DVA-4/RobotChant/THIRD_PARTY.md

# Third-party material

The firmware and tools are GPL-2.0 (see `LICENSE`). This file lists what came
from elsewhere and under what terms.

## `firmware/07j_pacing/standardDict.cpp`

The 1,427-word dictionary from Mike McCauley's
[SpeakJet library for Arduino](https://www.airspayce.com/mikem/arduino/SpeakJet/),
Copyright (C) 2011 Mike McCauley, licensed under the **GNU GPL version 2**.
McCauley generated it with his `convertDict.pl` from Sensory's `PhraseALator.Dic`.

**Modified for this project** (the pronunciation data is untouched):
the include was changed from `<SpeakJet.h>` to `"dict.h"`, the type name
`SpeakJet::DictionaryEntry` to `DictionaryEntry`, and a stray `extern` on an
initialised definition was removed.

Because this file is GPL v2, the firmware as a whole is distributed under GPL v2.

## `firmware/07j_pacing/extradict.h`, sections 2–5

Generated by `tools/dic2extradict.py` from Sensory's `PhraseALator.Dic`, the
dictionary shipped with Sensory's Phrase-A-Lator software for the SpeakJet. The
translation follows the rules of the original Phrase-A-Lator as re-implemented in
[benbaker76/PhraseALator](https://github.com/benbaker76/PhraseALator).
`PhraseALator.Dic` itself is **not** included in this repository.

Section 1 of the file is original work.

## `firmware/07j_pacing/bigdict.cpp`, `bigdict.h`

Generated by `tools/cmu2bigdict.py`. The pronunciations are derived from the
[CMU Pronouncing Dictionary](https://github.com/cmusphinx/cmudict), whose licence
requires the notice below. The words were chosen using the frequency ranking of
[wordfreq](https://github.com/rspeer/wordfreq) (Apache-2.0), which the tool uses
at generation time and which is not redistributed here. The conversion model is
trained on the Sensory data in `standardDict.cpp`.

```
Copyright (C) 1993-2015 Carnegie Mellon University. All rights reserved.

Redistribution and use in source and binary forms, with or without
modification, are permitted provided that the following conditions
are met:

1. Redistributions of source code must retain the above copyright
   notice, this list of conditions and the following disclaimer.
   The contents of this file are deemed to be source code.

2. Redistributions in binary form must reproduce the above copyright
   notice, this list of conditions and the following disclaimer in
   the documentation and/or other materials provided with the
   distribution.

This work was supported in part by funding from the Defense Advanced
Research Projects Agency, the Office of Naval Research and the National
Science Foundation of the United States of America, and by member
companies of the Carnegie Mellon Sphinx Speech Consortium. We acknowledge
the contributions of many volunteers to the expansion and improvement of
this dictionary.

THIS SOFTWARE IS PROVIDED BY CARNEGIE MELLON UNIVERSITY ``AS IS'' AND
ANY EXPRESSED OR IMPLIED WARRANTIES, INCLUDING, BUT NOT LIMITED TO,
THE IMPLIED WARRANTIES OF MERCHANTABILITY AND FITNESS FOR A PARTICULAR
PURPOSE ARE DISCLAIMED.  IN NO EVENT SHALL CARNEGIE MELLON UNIVERSITY
NOR ITS EMPLOYEES BE LIABLE FOR ANY DIRECT, INDIRECT, INCIDENTAL,
SPECIAL, EXEMPLARY, OR CONSEQUENTIAL DAMAGES (INCLUDING, BUT NOT
LIMITED TO, PROCUREMENT OF SUBSTITUTE GOODS OR SERVICES; LOSS OF USE,
DATA, OR PROFITS; OR BUSINESS INTERRUPTION) HOWEVER CAUSED AND ON ANY
THEORY OF LIABILITY, WHETHER IN CONTRACT, STRICT LIABILITY, OR TORT
(INCLUDING NEGLIGENCE OR OTHERWISE) ARISING IN ANY WAY OUT OF THE USE
OF THIS SOFTWARE, EVEN IF ADVISED OF THE POSSIBILITY OF SUCH DAMAGE.
```

## `firmware/07j_pacing/tab5kbd.h`, `docs/tab5_keyboard_reference.md`

An original driver. The register map and key-name strings were taken from
M5Stack's protocol documents and keyboard firmware in
[m5stack/M5Tab5-Keyboard-Internal-FW](https://github.com/m5stack/M5Tab5-Keyboard-Internal-FW)
(MIT licence, Copyright M5Stack Technology Co., Ltd).

## `firmware/07j_pacing/eltro_font5x7.h`

5×7 bitmap font. Original work by the author of this project, carried over from
an earlier project. It is released under the **MIT licence**, separately from the
GPL-2.0 firmware, so it can be reused in any project:

```
MIT License

Copyright (c) 2026 Fabian Rieber

Permission is hereby granted, free of charge, to any person obtaining a copy
of this software and associated documentation files (the "Software"), to deal
in the Software without restriction, including without limitation the rights
to use, copy, modify, merge, publish, distribute, sublicense, and/or sell
copies of the Software, and to permit persons to whom the Software is
furnished to do so, subject to the following conditions:

The above copyright notice and this permission notice shall be included in all
copies or substantial portions of the Software.

THE SOFTWARE IS PROVIDED "AS IS", WITHOUT WARRANTY OF ANY KIND, EXPRESS OR
IMPLIED, INCLUDING BUT NOT LIMITED TO THE WARRANTIES OF MERCHANTABILITY,
FITNESS FOR A PARTICULAR PURPOSE AND NONINFRINGEMENT. IN NO EVENT SHALL THE
AUTHORS OR COPYRIGHT HOLDERS BE LIABLE FOR ANY CLAIM, DAMAGES OR OTHER
LIABILITY, WHETHER IN AN ACTION OF CONTRACT, TORT OR OTHERWISE, ARISING FROM,
OUT OF OR IN CONNECTION WITH THE SOFTWARE OR THE USE OR OTHER DEALINGS IN THE
SOFTWARE.
```

## Referenced but not included

- **SpeakJet user manual** (Magnevation / Sensory) — widely mirrored, e.g. on
  SparkFun's product pages.
- **Voice Box Shield schematic** — SparkFun, available from the product page.
