DVA-4/RobotChant/firmware/07j_pacing/standardDict.cpp

// standardDict.cpp — 1427-word dictionary from Mike McCauley's SpeakJet library
// (converted by his convertDict.pl from SpeakJet's own PhraseALator.Dic).
//
// MODIFIED FOR THIS PROJECT — two changes only, data untouched:
//   1. #include <SpeakJet.h>  ->  #include "dict.h"
//   2. SpeakJet::DictionaryEntry -> DictionaryEntry, and dropped the stray
//      'extern' on a definition with an initialiser.
// We take the library's DATA but not its CODE: its speaking machinery uses
// SoftwareSerial, blocking per-code RDY polling, and speak-a-whole-string,
// all of which conflict with this project's hardware UART + non-blocking
// FIFO writes + one-token-per-note design.
// SpeakJet library dictionary file
// created by:
// convertDict.pl -name standard PhraseALator.Dic
// You probably dont want to edit this by hand, but instead alter the .dic file
// and rerun the converter
//
#include "dict.h"
PROGMEM const char _dict_standard_word_0[] = "a";
PROGMEM const uint8_t _dict_standard_code_0[] = { 154, 128, 255 };
PROGMEM const char _dict_standard_word_1[] = "able";
PROGMEM const uint8_t _dict_standard_code_1[] = { 7, 154, 171, 138, 145, 255 };
PROGMEM const char _dict_standard_word_2[] = "about";
PROGMEM const uint8_t _dict_standard_code_2[] = { 134, 173, 163, 191, 255 };
PROGMEM const char _dict_standard_word_3[] = "across";
PROGMEM const uint8_t _dict_standard_code_3[] = { 133, 196, 7, 148, 135, 187, 187, 255 };
PROGMEM const char _dict_standard_word_4[] = "act";
PROGMEM const uint8_t _dict_standard_code_4[] = { 132, 196, 191, 255 };
PROGMEM const char _dict_standard_word_5[] = "acting";
PROGMEM const uint8_t _dict_standard_code_5[] = { 132, 196, 191, 14, 129, 143, 255 };
PROGMEM const char _dict_standard_word_6[] = "activated";
PROGMEM const uint8_t _dict_standard_code_6[] = { 132, 194, 191, 7, 129, 166, 7, 154, 191, 129, 176, 255 };
PROGMEM const char _dict_standard_word_7[] = "add";
PROGMEM const uint8_t _dict_standard_code_7[] = { 132, 132, 176, 255 };
PROGMEM const char _dict_standard_word_8[] = "address";
PROGMEM const uint8_t _dict_standard_code_8[] = { 8, 132, 176, 7, 148, 131, 8, 187, 255 };
PROGMEM const char _dict_standard_word_9[] = "adorn";
PROGMEM const uint8_t _dict_standard_code_9[] = { 8, 133, 175, 7, 153, 141, 255 };
PROGMEM const char _dict_standard_word_10[] = "afraid";
PROGMEM const uint8_t _dict_standard_code_10[] = { 133, 186, 7, 148, 154, 176, 255 };
PROGMEM const char _dict_standard_word_11[] = "after";
PROGMEM const uint8_t _dict_standard_code_11[] = { 132, 186, 191, 7, 151, 255 };
PROGMEM const char _dict_standard_word_12[] = "afternoon";
PROGMEM const uint8_t _dict_standard_code_12[] = { 132, 186, 7, 191, 7, 151, 7, 141, 139, 8, 141, 255 };
PROGMEM const char _dict_standard_word_13[] = "again";
PROGMEM const uint8_t _dict_standard_code_13[] = { 133, 178, 8, 130, 141, 255 };
PROGMEM const char _dict_standard_word_14[] = "against";
PROGMEM const uint8_t _dict_standard_code_14[] = { 133, 178, 130, 141, 187, 8, 191, 255 };
PROGMEM const char _dict_standard_word_15[] = "air";
PROGMEM const uint8_t _dict_standard_code_15[] = { 150, 255 };
PROGMEM const char _dict_standard_word_16[] = "airplane";
PROGMEM const uint8_t _dict_standard_code_16[] = { 150, 199, 7, 145, 154, 141, 255 };
PROGMEM const char _dict_standard_word_17[] = "alarm";
PROGMEM const uint8_t _dict_standard_code_17[] = { 8, 134, 145, 152, 140, 255 };
PROGMEM const char _dict_standard_word_18[] = "alert";
PROGMEM const uint8_t _dict_standard_code_18[] = { 133, 145, 151, 191, 255 };
PROGMEM const char _dict_standard_word_19[] = "alien";
PROGMEM const uint8_t _dict_standard_code_19[] = { 7, 130, 7, 154, 145, 128, 8, 7, 133, 141, 255 };
PROGMEM const char _dict_standard_word_20[] = "alive";
PROGMEM const uint8_t _dict_standard_code_20[] = { 134, 145, 7, 135, 7, 155, 166, 255 };
PROGMEM const char _dict_standard_word_21[] = "all";
PROGMEM const uint8_t _dict_standard_code_21[] = { 8, 136, 8, 146, 255 };
PROGMEM const char _dict_standard_word_22[] = "alligator";
PROGMEM const uint8_t _dict_standard_code_22[] = { 132, 145, 7, 129, 178, 15, 154, 191, 7, 151, 255 };
PROGMEM const char _dict_standard_word_23[] = "almost";
PROGMEM const uint8_t _dict_standard_code_23[] = { 135, 7, 146, 140, 14, 137, 188, 191, 255 };
PROGMEM const char _dict_standard_word_24[] = "alone";
PROGMEM const uint8_t _dict_standard_code_24[] = { 134, 146, 137, 137, 8, 141, 255 };
PROGMEM const char _dict_standard_word_25[] = "along";
PROGMEM const uint8_t _dict_standard_code_25[] = { 134, 146, 135, 135, 8, 144, 255 };
PROGMEM const char _dict_standard_word_26[] = "alpha";
PROGMEM const uint8_t _dict_standard_code_26[] = { 132, 145, 7, 186, 134, 255 };
PROGMEM const char _dict_standard_word_27[] = "alphabet";
PROGMEM const uint8_t _dict_standard_code_27[] = { 132, 146, 7, 186, 7, 133, 14, 18, 170, 130, 8, 191, 255 };
PROGMEM const char _dict_standard_word_28[] = "already";
PROGMEM const uint8_t _dict_standard_code_28[] = { 136, 145, 7, 148, 130, 174, 128, 255 };
PROGMEM const char _dict_standard_word_29[] = "also";
PROGMEM const uint8_t _dict_standard_code_29[] = { 8, 136, 8, 146, 8, 188, 164, 255 };
PROGMEM const char _dict_standard_word_30[] = "although";
PROGMEM const uint8_t _dict_standard_code_30[] = { 7, 135, 8, 146, 169, 8, 164, 255 };
PROGMEM const char _dict_standard_word_31[] = "always";
PROGMEM const uint8_t _dict_standard_code_31[] = { 8, 136, 145, 147, 154, 8, 187, 255 };
PROGMEM const char _dict_standard_word_32[] = "am";
PROGMEM const uint8_t _dict_standard_code_32[] = { 132, 132, 140, 255 };
PROGMEM const char _dict_standard_word_33[] = "among";
PROGMEM const uint8_t _dict_standard_code_33[] = { 15, 134, 140, 134, 144, 255 };
PROGMEM const char _dict_standard_word_34[] = "ample";
PROGMEM const uint8_t _dict_standard_code_34[] = { 8, 132, 7, 140, 199, 134, 146, 255 };
PROGMEM const char _dict_standard_word_35[] = "an";
PROGMEM const uint8_t _dict_standard_code_35[] = { 132, 132, 141, 255 };
PROGMEM const char _dict_standard_word_36[] = "anchor";
PROGMEM const uint8_t _dict_standard_code_36[] = { 7, 154, 143, 194, 148, 255 };
PROGMEM const char _dict_standard_word_37[] = "and";
PROGMEM const uint8_t _dict_standard_code_37[] = { 8, 132, 8, 141, 177, 255 };
PROGMEM const char _dict_standard_word_38[] = "anger";
PROGMEM const uint8_t _dict_standard_code_38[] = { 7, 154, 7, 128, 7, 141, 178, 133, 148, 255 };
PROGMEM const char _dict_standard_word_39[] = "angle";
PROGMEM const uint8_t _dict_standard_code_39[] = { 154, 143, 145, 255 };
PROGMEM const char _dict_standard_word_40[] = "animal";
PROGMEM const uint8_t _dict_standard_code_40[] = { 8, 132, 141, 7, 129, 140, 8, 145, 255 };
PROGMEM const char _dict_standard_word_41[] = "another";
PROGMEM const uint8_t _dict_standard_code_41[] = { 134, 141, 134, 169, 151, 255 };
PROGMEM const char _dict_standard_word_42[] = "answer";
PROGMEM const uint8_t _dict_standard_code_42[] = { 132, 141, 8, 187, 151, 255 };
PROGMEM const char _dict_standard_word_43[] = "ant";
PROGMEM const uint8_t _dict_standard_code_43[] = { 8, 132, 141, 191, 255 };
PROGMEM const char _dict_standard_word_44[] = "any";
PROGMEM const uint8_t _dict_standard_code_44[] = { 14, 130, 141, 128, 128, 255 };
PROGMEM const char _dict_standard_word_45[] = "apart";
PROGMEM const uint8_t _dict_standard_code_45[] = { 134, 14, 199, 152, 191, 255 };
PROGMEM const char _dict_standard_word_46[] = "apartment";
PROGMEM const uint8_t _dict_standard_code_46[] = { 134, 14, 199, 7, 152, 191, 140, 130, 141, 191, 255 };
PROGMEM const char _dict_standard_word_47[] = "ape";
PROGMEM const uint8_t _dict_standard_code_47[] = { 154, 199, 255 };
PROGMEM const char _dict_standard_word_48[] = "appear";
PROGMEM const uint8_t _dict_standard_code_48[] = { 134, 8, 198, 149, 255 };
PROGMEM const char _dict_standard_word_49[] = "apple";
PROGMEM const uint8_t _dict_standard_code_49[] = { 132, 199, 8, 138, 145, 255 };
PROGMEM const char _dict_standard_word_50[] = "april";
PROGMEM const uint8_t _dict_standard_code_50[] = { 154, 198, 148, 145, 255 };
PROGMEM const char _dict_standard_word_51[] = "are";
PROGMEM const uint8_t _dict_standard_code_51[] = { 152, 255 };
PROGMEM const char _dict_standard_word_52[] = "arm";
PROGMEM const uint8_t _dict_standard_code_52[] = { 152, 140, 255 };
PROGMEM const char _dict_standard_word_53[] = "army";
PROGMEM const uint8_t _dict_standard_code_53[] = { 7, 136, 148, 140, 128, 255 };
PROGMEM const char _dict_standard_word_54[] = "around";
PROGMEM const uint8_t _dict_standard_code_54[] = { 134, 7, 148, 163, 141, 177, 255 };
PROGMEM const char _dict_standard_word_55[] = "arrow";
PROGMEM const uint8_t _dict_standard_code_55[] = { 150, 164, 255 };
PROGMEM const char _dict_standard_word_56[] = "art";
PROGMEM const uint8_t _dict_standard_code_56[] = { 152, 191, 255 };
PROGMEM const char _dict_standard_word_57[] = "as";
PROGMEM const uint8_t _dict_standard_code_57[] = { 132, 8, 167, 255 };
PROGMEM const char _dict_standard_word_58[] = "ask";
PROGMEM const uint8_t _dict_standard_code_58[] = { 8, 132, 8, 187, 196, 255 };
PROGMEM const char _dict_standard_word_59[] = "asleep";
PROGMEM const uint8_t _dict_standard_code_59[] = { 133, 8, 187, 145, 128, 7, 198, 255 };
PROGMEM const char _dict_standard_word_60[] = "ass";
PROGMEM const uint8_t _dict_standard_code_60[] = { 132, 132, 8, 187, 255 };
PROGMEM const char _dict_standard_word_61[] = "astronaut";
PROGMEM const uint8_t _dict_standard_code_61[] = { 132, 187, 4, 191, 7, 148, 7, 137, 7, 142, 135, 191, 255 };
PROGMEM const char _dict_standard_word_62[] = "at";
PROGMEM const uint8_t _dict_standard_code_62[] = { 132, 8, 191, 255 };
PROGMEM const char _dict_standard_word_63[] = "ate";
PROGMEM const uint8_t _dict_standard_code_63[] = { 154, 191, 255 };
PROGMEM const char _dict_standard_word_64[] = "aught";
PROGMEM const uint8_t _dict_standard_code_64[] = { 8, 136, 8, 191, 255 };
PROGMEM const char _dict_standard_word_65[] = "august";
PROGMEM const uint8_t _dict_standard_code_65[] = { 8, 136, 179, 133, 187, 191, 255 };
PROGMEM const char _dict_standard_word_66[] = "aunt";
PROGMEM const uint8_t _dict_standard_code_66[] = { 135, 141, 191, 255 };
PROGMEM const char _dict_standard_word_67[] = "automobile";
PROGMEM const uint8_t _dict_standard_code_67[] = { 8, 136, 191, 7, 164, 7, 140, 7, 164, 18, 170, 128, 145, 255 };
PROGMEM const char _dict_standard_word_68[] = "autumn";
PROGMEM const uint8_t _dict_standard_code_68[] = { 135, 191, 133, 140, 140, 255 };
PROGMEM const char _dict_standard_word_69[] = "avenue";
PROGMEM const uint8_t _dict_standard_code_69[] = { 132, 166, 130, 141, 160, 255 };
PROGMEM const char _dict_standard_word_70[] = "awake";
PROGMEM const uint8_t _dict_standard_code_70[] = { 134, 147, 154, 194, 255 };
PROGMEM const char _dict_standard_word_71[] = "away";
PROGMEM const uint8_t _dict_standard_code_71[] = { 133, 147, 154, 255 };
PROGMEM const char _dict_standard_word_72[] = "ax";
PROGMEM const uint8_t _dict_standard_code_72[] = { 132, 132, 196, 187, 255 };
PROGMEM const char _dict_standard_word_73[] = "azure";
PROGMEM const uint8_t _dict_standard_code_73[] = { 8, 133, 168, 7, 162, 148, 255 };
PROGMEM const char _dict_standard_word_74[] = "b";
PROGMEM const uint8_t _dict_standard_code_74[] = { 170, 128, 128, 255 };
PROGMEM const char _dict_standard_word_75[] = "babblebot";
PROGMEM const uint8_t _dict_standard_code_75[] = { 170, 132, 173, 8, 146, 171, 136, 191, 255 };
PROGMEM const char _dict_standard_word_76[] = "baby";
PROGMEM const uint8_t _dict_standard_code_76[] = { 170, 154, 172, 128, 255 };
PROGMEM const char _dict_standard_word_77[] = "back";
PROGMEM const uint8_t _dict_standard_code_77[] = { 170, 8, 132, 4, 196, 255 };
PROGMEM const char _dict_standard_word_78[] = "bad";
PROGMEM const uint8_t _dict_standard_code_78[] = { 170, 132, 132, 176, 255 };
PROGMEM const char _dict_standard_word_79[] = "bag";
PROGMEM const uint8_t _dict_standard_code_79[] = { 170, 132, 132, 180, 255 };
PROGMEM const char _dict_standard_word_80[] = "bake";
PROGMEM const uint8_t _dict_standard_code_80[] = { 170, 154, 194, 255 };
PROGMEM const char _dict_standard_word_81[] = "ball";
PROGMEM const uint8_t _dict_standard_code_81[] = { 171, 8, 135, 146, 255 };
PROGMEM const char _dict_standard_word_82[] = "balloon";
PROGMEM const uint8_t _dict_standard_code_82[] = { 171, 7, 134, 145, 139, 139, 141, 255 };
PROGMEM const char _dict_standard_word_83[] = "banana";
PROGMEM const uint8_t _dict_standard_code_83[] = { 171, 7, 134, 141, 132, 141, 133, 255 };
PROGMEM const char _dict_standard_word_84[] = "band";
PROGMEM const uint8_t _dict_standard_code_84[] = { 170, 8, 132, 141, 177, 255 };
PROGMEM const char _dict_standard_word_85[] = "basic";
PROGMEM const uint8_t _dict_standard_code_85[] = { 170, 154, 187, 129, 7, 4, 197, 255 };
PROGMEM const char _dict_standard_word_86[] = "bathe";
PROGMEM const uint8_t _dict_standard_code_86[] = { 170, 154, 169, 255 };
PROGMEM const char _dict_standard_word_87[] = "bather";
PROGMEM const uint8_t _dict_standard_code_87[] = { 170, 154, 169, 7, 151, 255 };
PROGMEM const char _dict_standard_word_88[] = "bathing";
PROGMEM const uint8_t _dict_standard_code_88[] = { 170, 154, 169, 129, 143, 255 };
PROGMEM const char _dict_standard_word_89[] = "beast";
PROGMEM const uint8_t _dict_standard_code_89[] = { 170, 128, 187, 191, 255 };
PROGMEM const char _dict_standard_word_90[] = "beauty";
PROGMEM const uint8_t _dict_standard_code_90[] = { 170, 160, 191, 128, 255 };
PROGMEM const char _dict_standard_word_91[] = "beer";
PROGMEM const uint8_t _dict_standard_code_91[] = { 170, 149, 255 };
PROGMEM const char _dict_standard_word_92[] = "beige";
PROGMEM const uint8_t _dict_standard_code_92[] = { 170, 130, 154, 165, 255 };
PROGMEM const char _dict_standard_word_93[] = "below";
PROGMEM const uint8_t _dict_standard_code_93[] = { 170, 128, 145, 164, 255 };
PROGMEM const char _dict_standard_word_94[] = "beta";
PROGMEM const uint8_t _dict_standard_code_94[] = { 170, 154, 191, 134, 255 };
PROGMEM const char _dict_standard_word_95[] = "bib";
PROGMEM const uint8_t _dict_standard_code_95[] = { 170, 129, 129, 172, 255 };
PROGMEM const char _dict_standard_word_96[] = "bird";
PROGMEM const uint8_t _dict_standard_code_96[] = { 7, 18, 170, 151, 176, 255 };
PROGMEM const char _dict_standard_word_97[] = "blast";
PROGMEM const uint8_t _dict_standard_code_97[] = { 171, 145, 132, 187, 191, 255 };
PROGMEM const char _dict_standard_word_98[] = "bleed";
PROGMEM const uint8_t _dict_standard_code_98[] = { 171, 145, 128, 174, 255 };
PROGMEM const char _dict_standard_word_99[] = "blue";
PROGMEM const uint8_t _dict_standard_code_99[] = { 171, 7, 146, 162, 255 };
PROGMEM const char _dict_standard_word_100[] = "bong";
PROGMEM const uint8_t _dict_standard_code_100[] = { 171, 135, 8, 144, 255 };
PROGMEM const char _dict_standard_word_101[] = "book";
PROGMEM const uint8_t _dict_standard_code_101[] = { 171, 8, 138, 197, 255 };
PROGMEM const char _dict_standard_word_102[] = "bot";
PROGMEM const uint8_t _dict_standard_code_102[] = { 171, 8, 135, 191, 255 };
PROGMEM const char _dict_standard_word_103[] = "boy";
PROGMEM const uint8_t _dict_standard_code_103[] = { 171, 156, 255 };
PROGMEM const char _dict_standard_word_104[] = "brain";
PROGMEM const uint8_t _dict_standard_code_104[] = { 171, 7, 148, 154, 141, 255 };
PROGMEM const char _dict_standard_word_105[] = "bread";
PROGMEM const uint8_t _dict_standard_code_105[] = { 7, 18, 170, 148, 8, 131, 176, 255 };
PROGMEM const char _dict_standard_word_106[] = "bright";
PROGMEM const uint8_t _dict_standard_code_106[] = { 171, 7, 148, 155, 191, 255 };
PROGMEM const char _dict_standard_word_107[] = "brightly";
PROGMEM const uint8_t _dict_standard_code_107[] = { 171, 7, 148, 155, 191, 145, 128, 255 };
PROGMEM const char _dict_standard_word_108[] = "broom";
PROGMEM const uint8_t _dict_standard_code_108[] = { 171, 7, 148, 8, 139, 140, 255 };
PROGMEM const char _dict_standard_word_109[] = "brooms";
PROGMEM const uint8_t _dict_standard_code_109[] = { 171, 7, 148, 8, 139, 140, 187, 255 };
PROGMEM const char _dict_standard_word_110[] = "brown";
PROGMEM const uint8_t _dict_standard_code_110[] = { 171, 7, 148, 161, 141, 255 };
PROGMEM const char _dict_standard_word_111[] = "brush";
PROGMEM const uint8_t _dict_standard_code_111[] = { 171, 7, 148, 8, 133, 189, 189, 255 };
PROGMEM const char _dict_standard_word_112[] = "burn";
PROGMEM const uint8_t _dict_standard_code_112[] = { 170, 151, 141, 255 };
PROGMEM const char _dict_standard_word_113[] = "business";
PROGMEM const uint8_t _dict_standard_code_113[] = { 170, 129, 167, 141, 129, 187, 255 };
PROGMEM const char _dict_standard_word_114[] = "by";
PROGMEM const uint8_t _dict_standard_code_114[] = { 171, 157, 255 };
PROGMEM const char _dict_standard_word_115[] = "c";
PROGMEM const uint8_t _dict_standard_code_115[] = { 187, 187, 128, 128, 255 };
PROGMEM const char _dict_standard_word_116[] = "cab";
PROGMEM const uint8_t _dict_standard_code_116[] = { 194, 132, 132, 172, 255 };
PROGMEM const char _dict_standard_word_117[] = "cake";
PROGMEM const uint8_t _dict_standard_code_117[] = { 194, 154, 15, 196, 255 };
PROGMEM const char _dict_standard_word_118[] = "calendar";
PROGMEM const uint8_t _dict_standard_code_118[] = { 194, 7, 132, 145, 131, 141, 175, 7, 151, 255 };
PROGMEM const char _dict_standard_word_119[] = "call";
PROGMEM const uint8_t _dict_standard_code_119[] = { 195, 8, 135, 146, 255 };
PROGMEM const char _dict_standard_word_120[] = "camel";
PROGMEM const uint8_t _dict_standard_code_120[] = { 194, 132, 140, 134, 145, 255 };
PROGMEM const char _dict_standard_word_121[] = "camp";
PROGMEM const uint8_t _dict_standard_code_121[] = { 194, 132, 140, 199, 255 };
PROGMEM const char _dict_standard_word_122[] = "can";
PROGMEM const uint8_t _dict_standard_code_122[] = { 194, 8, 132, 141, 255 };
PROGMEM const char _dict_standard_word_123[] = "candle";
PROGMEM const uint8_t _dict_standard_code_123[] = { 194, 8, 132, 141, 174, 159, 255 };
PROGMEM const char _dict_standard_word_124[] = "candy";
PROGMEM const uint8_t _dict_standard_code_124[] = { 194, 132, 141, 174, 8, 128, 255 };
PROGMEM const char _dict_standard_word_125[] = "cap";
PROGMEM const uint8_t _dict_standard_code_125[] = { 194, 8, 132, 199, 255 };
PROGMEM const char _dict_standard_word_126[] = "car";
PROGMEM const uint8_t _dict_standard_code_126[] = { 195, 8, 136, 148, 255 };
PROGMEM const char _dict_standard_word_127[] = "care";
PROGMEM const uint8_t _dict_standard_code_127[] = { 196, 130, 150, 255 };
PROGMEM const char _dict_standard_word_128[] = "carpet";
PROGMEM const uint8_t _dict_standard_code_128[] = { 195, 7, 152, 198, 129, 191, 255 };
PROGMEM const char _dict_standard_word_129[] = "carriage";
PROGMEM const uint8_t _dict_standard_code_129[] = { 196, 7, 150, 8, 129, 165, 255 };
PROGMEM const char _dict_standard_word_130[] = "carrot";
PROGMEM const uint8_t _dict_standard_code_130[] = { 196, 7, 150, 133, 191, 255 };
PROGMEM const char _dict_standard_word_131[] = "casual";
PROGMEM const uint8_t _dict_standard_code_131[] = { 194, 132, 168, 7, 162, 133, 145, 255 };
PROGMEM const char _dict_standard_word_132[] = "cat";
PROGMEM const uint8_t _dict_standard_code_132[] = { 194, 132, 191, 255 };
PROGMEM const char _dict_standard_word_133[] = "catch";
PROGMEM const uint8_t _dict_standard_code_133[] = { 194, 8, 132, 4, 182, 255 };
PROGMEM const char _dict_standard_word_134[] = "cent";
PROGMEM const uint8_t _dict_standard_code_134[] = { 187, 130, 141, 4, 191, 255 };
PROGMEM const char _dict_standard_word_135[] = "center";
PROGMEM const uint8_t _dict_standard_code_135[] = { 187, 130, 141, 191, 7, 151, 255 };
PROGMEM const char _dict_standard_word_136[] = "certain";
PROGMEM const uint8_t _dict_standard_code_136[] = { 8, 187, 7, 151, 191, 131, 141, 255 };
PROGMEM const char _dict_standard_word_137[] = "chair";
PROGMEM const uint8_t _dict_standard_code_137[] = { 182, 150, 255 };
PROGMEM const char _dict_standard_word_138[] = "chalk";
PROGMEM const uint8_t _dict_standard_code_138[] = { 8, 182, 135, 7, 146, 197, 255 };
PROGMEM const char _dict_standard_word_139[] = "change";
PROGMEM const uint8_t _dict_standard_code_139[] = { 182, 154, 141, 165, 255 };
PROGMEM const char _dict_standard_word_140[] = "changeable";
PROGMEM const uint8_t _dict_standard_code_140[] = { 182, 7, 154, 7, 141, 7, 165, 133, 172, 134, 8, 145, 255 };
PROGMEM const char _dict_standard_word_141[] = "check";
PROGMEM const uint8_t _dict_standard_code_141[] = { 182, 131, 131, 196, 255 };
PROGMEM const char _dict_standard_word_142[] = "checked";
PROGMEM const uint8_t _dict_standard_code_142[] = { 182, 131, 131, 196, 191, 255 };
PROGMEM const char _dict_standard_word_143[] = "checker";
PROGMEM const uint8_t _dict_standard_code_143[] = { 182, 131, 131, 194, 133, 148, 255 };
PROGMEM const char _dict_standard_word_144[] = "checkers";
PROGMEM const uint8_t _dict_standard_code_144[] = { 182, 131, 131, 194, 133, 148, 167, 255 };
PROGMEM const char _dict_standard_word_145[] = "checking";
PROGMEM const uint8_t _dict_standard_code_145[] = { 182, 131, 131, 194, 129, 143, 255 };
PROGMEM const char _dict_standard_word_146[] = "checks";
PROGMEM const uint8_t _dict_standard_code_146[] = { 182, 131, 131, 194, 187, 255 };
PROGMEM const char _dict_standard_word_147[] = "cheek";
PROGMEM const uint8_t _dict_standard_code_147[] = { 182, 8, 128, 194, 255 };
PROGMEM const char _dict_standard_word_148[] = "cherry";
PROGMEM const uint8_t _dict_standard_code_148[] = { 8, 182, 7, 150, 128, 255 };
PROGMEM const char _dict_standard_word_149[] = "chest";
PROGMEM const uint8_t _dict_standard_code_149[] = { 182, 131, 131, 187, 191, 255 };
PROGMEM const char _dict_standard_word_150[] = "chests";
PROGMEM const uint8_t _dict_standard_code_150[] = { 182, 131, 131, 187, 193, 255 };
PROGMEM const char _dict_standard_word_151[] = "chi";
PROGMEM const uint8_t _dict_standard_code_151[] = { 195, 155, 255 };
PROGMEM const char _dict_standard_word_152[] = "chicken";
PROGMEM const uint8_t _dict_standard_code_152[] = { 182, 129, 194, 131, 141, 255 };
PROGMEM const char _dict_standard_word_153[] = "chip";
PROGMEM const uint8_t _dict_standard_code_153[] = { 182, 129, 129, 198, 255 };
PROGMEM const char _dict_standard_word_154[] = "chips";
PROGMEM const uint8_t _dict_standard_code_154[] = { 182, 129, 129, 198, 187, 255 };
PROGMEM const char _dict_standard_word_155[] = "church";
PROGMEM const uint8_t _dict_standard_code_155[] = { 182, 133, 148, 182, 255 };
PROGMEM const char _dict_standard_word_156[] = "circle";
PROGMEM const uint8_t _dict_standard_code_156[] = { 8, 188, 7, 151, 195, 138, 146, 255 };
PROGMEM const char _dict_standard_word_157[] = "circus";
PROGMEM const uint8_t _dict_standard_code_157[] = { 8, 188, 7, 151, 194, 133, 8, 188, 255 };
PROGMEM const char _dict_standard_word_158[] = "city";
PROGMEM const uint8_t _dict_standard_code_158[] = { 8, 187, 8, 129, 191, 128, 255 };
PROGMEM const char _dict_standard_word_159[] = "clap";
PROGMEM const uint8_t _dict_standard_code_159[] = { 195, 7, 145, 132, 199, 255 };
PROGMEM const char _dict_standard_word_160[] = "class";
PROGMEM const uint8_t _dict_standard_code_160[] = { 8, 195, 7, 145, 8, 132, 8, 187, 255 };
PROGMEM const char _dict_standard_word_161[] = "clean";
PROGMEM const uint8_t _dict_standard_code_161[] = { 8, 195, 7, 145, 8, 128, 141, 255 };
PROGMEM const char _dict_standard_word_162[] = "clear";
PROGMEM const uint8_t _dict_standard_code_162[] = { 8, 195, 7, 145, 149, 255 };
PROGMEM const char _dict_standard_word_163[] = "climb";
PROGMEM const uint8_t _dict_standard_code_163[] = { 8, 195, 7, 145, 157, 8, 140, 255 };
PROGMEM const char _dict_standard_word_164[] = "clock";
PROGMEM const uint8_t _dict_standard_code_164[] = { 8, 195, 7, 146, 8, 135, 197, 255 };
PROGMEM const char _dict_standard_word_165[] = "close";
PROGMEM const uint8_t _dict_standard_code_165[] = { 8, 195, 7, 145, 164, 7, 167, 255 };
PROGMEM const char _dict_standard_word_166[] = "closet";
PROGMEM const uint8_t _dict_standard_code_166[] = { 8, 195, 7, 146, 8, 135, 7, 167, 131, 191, 255 };
PROGMEM const char _dict_standard_word_167[] = "cloth";
PROGMEM const uint8_t _dict_standard_code_167[] = { 8, 195, 7, 145, 8, 135, 190, 190, 255 };
PROGMEM const char _dict_standard_word_168[] = "clothes";
PROGMEM const uint8_t _dict_standard_code_168[] = { 8, 195, 7, 145, 164, 7, 167, 255 };
PROGMEM const char _dict_standard_word_169[] = "cloud";
PROGMEM const uint8_t _dict_standard_code_169[] = { 8, 195, 7, 145, 163, 177, 255 };
PROGMEM const char _dict_standard_word_170[] = "clown";
PROGMEM const uint8_t _dict_standard_code_170[] = { 8, 195, 7, 145, 163, 142, 255 };
PROGMEM const char _dict_standard_word_171[] = "coat";
PROGMEM const uint8_t _dict_standard_code_171[] = { 195, 164, 191, 255 };
PROGMEM const char _dict_standard_word_172[] = "cob";
PROGMEM const uint8_t _dict_standard_code_172[] = { 195, 8, 135, 7, 4, 173, 255 };
PROGMEM const char _dict_standard_word_173[] = "cognitive";
PROGMEM const uint8_t _dict_standard_code_173[] = { 195, 135, 179, 7, 141, 7, 129, 191, 129, 166, 255 };
PROGMEM const char _dict_standard_word_174[] = "coin";
PROGMEM const uint8_t _dict_standard_code_174[] = { 197, 156, 141, 255 };
PROGMEM const char _dict_standard_word_175[] = "cold";
PROGMEM const uint8_t _dict_standard_code_175[] = { 197, 164, 146, 7, 175, 255 };
PROGMEM const char _dict_standard_word_176[] = "collide";
PROGMEM const uint8_t _dict_standard_code_176[] = { 195, 134, 145, 157, 176, 255 };
PROGMEM const char _dict_standard_word_177[] = "color";
PROGMEM const uint8_t _dict_standard_code_177[] = { 195, 8, 134, 146, 7, 151, 255 };
PROGMEM const char _dict_standard_word_178[] = "com";
PROGMEM const uint8_t _dict_standard_code_178[] = { 195, 135, 135, 140, 255 };
PROGMEM const char _dict_standard_word_179[] = "comb";
PROGMEM const uint8_t _dict_standard_code_179[] = { 195, 137, 140, 255 };
PROGMEM const char _dict_standard_word_180[] = "come";
PROGMEM const uint8_t _dict_standard_code_180[] = { 194, 8, 134, 140, 255 };
PROGMEM const char _dict_standard_word_181[] = "computer";
PROGMEM const uint8_t _dict_standard_code_181[] = { 194, 134, 140, 7, 198, 7, 160, 191, 133, 148, 255 };
PROGMEM const char _dict_standard_word_182[] = "computers";
PROGMEM const uint8_t _dict_standard_code_182[] = { 194, 134, 140, 7, 198, 7, 160, 191, 133, 148, 187, 255 };
PROGMEM const char _dict_standard_word_183[] = "contain";
PROGMEM const uint8_t _dict_standard_code_183[] = { 194, 133, 141, 191, 154, 141, 255 };
PROGMEM const char _dict_standard_word_184[] = "container";
PROGMEM const uint8_t _dict_standard_code_184[] = { 194, 133, 141, 191, 7, 154, 141, 7, 151, 255 };
PROGMEM const char _dict_standard_word_185[] = "cook";
PROGMEM const uint8_t _dict_standard_code_185[] = { 195, 8, 138, 195, 255 };
PROGMEM const char _dict_standard_word_186[] = "cookie";
PROGMEM const uint8_t _dict_standard_code_186[] = { 195, 8, 138, 194, 128, 255 };
PROGMEM const char _dict_standard_word_187[] = "cool";
PROGMEM const uint8_t _dict_standard_code_187[] = { 195, 8, 139, 145, 255 };
PROGMEM const char _dict_standard_word_188[] = "coop";
PROGMEM const uint8_t _dict_standard_code_188[] = { 194, 139, 139, 199, 255 };
PROGMEM const char _dict_standard_word_189[] = "copy";
PROGMEM const uint8_t _dict_standard_code_189[] = { 195, 8, 135, 198, 7, 128, 255 };
PROGMEM const char _dict_standard_word_190[] = "core";
PROGMEM const uint8_t _dict_standard_code_190[] = { 195, 8, 153, 255 };
PROGMEM const char _dict_standard_word_191[] = "cork";
PROGMEM const uint8_t _dict_standard_code_191[] = { 195, 153, 196, 255 };
PROGMEM const char _dict_standard_word_192[] = "corn";
PROGMEM const uint8_t _dict_standard_code_192[] = { 195, 153, 142, 255 };
PROGMEM const char _dict_standard_word_193[] = "corner";
PROGMEM const uint8_t _dict_standard_code_193[] = { 195, 7, 153, 141, 7, 151, 255 };
PROGMEM const char _dict_standard_word_194[] = "corona";
PROGMEM const uint8_t _dict_standard_code_194[] = { 195, 137, 148, 137, 142, 133, 255 };
PROGMEM const char _dict_standard_word_195[] = "correct";
PROGMEM const uint8_t _dict_standard_code_195[] = { 195, 153, 131, 196, 191, 255 };
PROGMEM const char _dict_standard_word_196[] = "corrected";
PROGMEM const uint8_t _dict_standard_code_196[] = { 195, 153, 131, 196, 191, 129, 176, 255 };
PROGMEM const char _dict_standard_word_197[] = "correcting";
PROGMEM const uint8_t _dict_standard_code_197[] = { 195, 153, 131, 196, 191, 129, 143, 255 };
PROGMEM const char _dict_standard_word_198[] = "corrects";
PROGMEM const uint8_t _dict_standard_code_198[] = { 195, 153, 131, 196, 193, 255 };
PROGMEM const char _dict_standard_word_199[] = "cost";
PROGMEM const uint8_t _dict_standard_code_199[] = { 195, 8, 136, 187, 191, 255 };
PROGMEM const char _dict_standard_word_200[] = "costs";
PROGMEM const uint8_t _dict_standard_code_200[] = { 195, 8, 136, 187, 193, 255 };
PROGMEM const char _dict_standard_word_201[] = "cotton";
PROGMEM const uint8_t _dict_standard_code_201[] = { 195, 8, 135, 191, 133, 141, 255 };
PROGMEM const char _dict_standard_word_202[] = "could";
PROGMEM const uint8_t _dict_standard_code_202[] = { 195, 138, 138, 177, 255 };
PROGMEM const char _dict_standard_word_203[] = "count";
PROGMEM const uint8_t _dict_standard_code_203[] = { 194, 7, 163, 141, 191, 255 };
PROGMEM const char _dict_standard_word_204[] = "country";
PROGMEM const uint8_t _dict_standard_code_204[] = { 195, 134, 141, 191, 148, 128, 255 };
PROGMEM const char _dict_standard_word_205[] = "cover";
PROGMEM const uint8_t _dict_standard_code_205[] = { 195, 134, 166, 151, 255 };
PROGMEM const char _dict_standard_word_206[] = "cow";
PROGMEM const uint8_t _dict_standard_code_206[] = { 195, 163, 255 };
PROGMEM const char _dict_standard_word_207[] = "cracker";
PROGMEM const uint8_t _dict_standard_code_207[] = { 196, 7, 148, 132, 194, 151, 255 };
PROGMEM const char _dict_standard_word_208[] = "crain";
PROGMEM const uint8_t _dict_standard_code_208[] = { 194, 148, 154, 141, 255 };
PROGMEM const char _dict_standard_word_209[] = "crayon";
PROGMEM const uint8_t _dict_standard_code_209[] = { 196, 148, 7, 154, 135, 141, 255 };
PROGMEM const char _dict_standard_word_210[] = "created";
PROGMEM const uint8_t _dict_standard_code_210[] = { 195, 7, 148, 128, 154, 191, 129, 176, 255 };
PROGMEM const char _dict_standard_word_211[] = "crib";
PROGMEM const uint8_t _dict_standard_code_211[] = { 195, 148, 8, 129, 172, 255 };
PROGMEM const char _dict_standard_word_212[] = "cross";
PROGMEM const uint8_t _dict_standard_code_212[] = { 197, 7, 148, 135, 8, 187, 255 };
PROGMEM const char _dict_standard_word_213[] = "crowd";
PROGMEM const uint8_t _dict_standard_code_213[] = { 195, 7, 148, 163, 177, 255 };
PROGMEM const char _dict_standard_word_214[] = "crown";
PROGMEM const uint8_t _dict_standard_code_214[] = { 194, 7, 148, 163, 141, 255 };
PROGMEM const char _dict_standard_word_215[] = "cry";
PROGMEM const uint8_t _dict_standard_code_215[] = { 195, 7, 148, 155, 255 };
PROGMEM const char _dict_standard_word_216[] = "cub";
PROGMEM const uint8_t _dict_standard_code_216[] = { 195, 8, 134, 172, 255 };
PROGMEM const char _dict_standard_word_217[] = "cup";
PROGMEM const uint8_t _dict_standard_code_217[] = { 195, 8, 134, 4, 199, 255 };
PROGMEM const char _dict_standard_word_218[] = "curb";
PROGMEM const uint8_t _dict_standard_code_218[] = { 195, 151, 172, 255 };
PROGMEM const char _dict_standard_word_219[] = "cut";
PROGMEM const uint8_t _dict_standard_code_219[] = { 194, 134, 4, 191, 255 };
PROGMEM const char _dict_standard_word_220[] = "cute";
PROGMEM const uint8_t _dict_standard_code_220[] = { 194, 160, 4, 191, 255 };
PROGMEM const char _dict_standard_word_221[] = "d";
PROGMEM const uint8_t _dict_standard_code_221[] = { 174, 128, 128, 255 };
PROGMEM const char _dict_standard_word_222[] = "daisy";
PROGMEM const uint8_t _dict_standard_code_222[] = { 174, 154, 167, 7, 128, 255 };
PROGMEM const char _dict_standard_word_223[] = "dance";
PROGMEM const uint8_t _dict_standard_code_223[] = { 174, 8, 132, 141, 8, 187, 255 };
PROGMEM const char _dict_standard_word_224[] = "danger";
PROGMEM const uint8_t _dict_standard_code_224[] = { 174, 154, 7, 141, 7, 165, 7, 151, 255 };
PROGMEM const char _dict_standard_word_225[] = "dark";
PROGMEM const uint8_t _dict_standard_code_225[] = { 175, 152, 4, 196, 255 };
PROGMEM const char _dict_standard_word_226[] = "date";
PROGMEM const uint8_t _dict_standard_code_226[] = { 174, 7, 154, 128, 4, 191, 255 };
PROGMEM const char _dict_standard_word_227[] = "daughter";
PROGMEM const uint8_t _dict_standard_code_227[] = { 174, 8, 136, 191, 7, 151, 255 };
PROGMEM const char _dict_standard_word_228[] = "day";
PROGMEM const uint8_t _dict_standard_code_228[] = { 174, 154, 255 };
PROGMEM const char _dict_standard_word_229[] = "deactivated";
PROGMEM const uint8_t _dict_standard_code_229[] = { 174, 128, 4, 132, 194, 191, 129, 166, 7, 154, 191, 129, 176, 255 };
PROGMEM const char _dict_standard_word_230[] = "dear";
PROGMEM const uint8_t _dict_standard_code_230[] = { 174, 128, 7, 149, 255 };
PROGMEM const char _dict_standard_word_231[] = "december";
PROGMEM const uint8_t _dict_standard_code_231[] = { 174, 7, 128, 187, 131, 140, 172, 7, 148, 255 };
PROGMEM const char _dict_standard_word_232[] = "declare";
PROGMEM const uint8_t _dict_standard_code_232[] = { 174, 7, 128, 4, 196, 7, 145, 150, 255 };
PROGMEM const char _dict_standard_word_233[] = "deep";
PROGMEM const uint8_t _dict_standard_code_233[] = { 174, 8, 128, 4, 198, 255 };
PROGMEM const char _dict_standard_word_234[] = "deer";
PROGMEM const uint8_t _dict_standard_code_234[] = { 174, 149, 255 };
PROGMEM const char _dict_standard_word_235[] = "delta";
PROGMEM const uint8_t _dict_standard_code_235[] = { 174, 159, 191, 7, 134, 255 };
PROGMEM const char _dict_standard_word_236[] = "dentist";
PROGMEM const uint8_t _dict_standard_code_236[] = { 174, 7, 130, 141, 191, 129, 187, 191, 255 };
PROGMEM const char _dict_standard_word_237[] = "desert";
PROGMEM const uint8_t _dict_standard_code_237[] = { 174, 14, 131, 167, 7, 151, 191, 255 };
PROGMEM const char _dict_standard_word_238[] = "desk";
PROGMEM const uint8_t _dict_standard_code_238[] = { 174, 131, 187, 194, 255 };
PROGMEM const char _dict_standard_word_239[] = "dessert";
PROGMEM const uint8_t _dict_standard_code_239[] = { 174, 131, 7, 167, 7, 151, 191, 255 };
PROGMEM const char _dict_standard_word_240[] = "dictionary";
PROGMEM const uint8_t _dict_standard_code_240[] = { 7, 174, 7, 14, 129, 194, 182, 133, 141, 7, 150, 128, 255 };
PROGMEM const char _dict_standard_word_241[] = "different";
PROGMEM const uint8_t _dict_standard_code_241[] = { 174, 7, 129, 186, 148, 7, 131, 141, 191, 255 };
PROGMEM const char _dict_standard_word_242[] = "difficult";
PROGMEM const uint8_t _dict_standard_code_242[] = { 174, 7, 129, 186, 129, 195, 7, 138, 145, 191, 255 };
PROGMEM const char _dict_standard_word_243[] = "dime";
PROGMEM const uint8_t _dict_standard_code_243[] = { 175, 155, 140, 255 };
PROGMEM const char _dict_standard_word_244[] = "dinner";
PROGMEM const uint8_t _dict_standard_code_244[] = { 174, 129, 141, 7, 151, 255 };
PROGMEM const char _dict_standard_word_245[] = "direction";
PROGMEM const uint8_t _dict_standard_code_245[] = { 174, 7, 151, 131, 194, 189, 133, 141, 255 };
PROGMEM const char _dict_standard_word_246[] = "dirt";
PROGMEM const uint8_t _dict_standard_code_246[] = { 174, 7, 133, 7, 151, 4, 191, 255 };
PROGMEM const char _dict_standard_word_247[] = "dirty";
PROGMEM const uint8_t _dict_standard_code_247[] = { 174, 7, 151, 191, 8, 128, 255 };
PROGMEM const char _dict_standard_word_248[] = "discover";
PROGMEM const uint8_t _dict_standard_code_248[] = { 174, 7, 129, 187, 194, 134, 166, 151, 255 };
PROGMEM const char _dict_standard_word_249[] = "dish";
PROGMEM const uint8_t _dict_standard_code_249[] = { 174, 8, 129, 8, 189, 255 };
PROGMEM const char _dict_standard_word_250[] = "distance";
PROGMEM const uint8_t _dict_standard_code_250[] = { 174, 7, 129, 187, 191, 133, 141, 8, 187, 255 };
PROGMEM const char _dict_standard_word_251[] = "divide";
PROGMEM const uint8_t _dict_standard_code_251[] = { 174, 7, 129, 166, 157, 174, 255 };
PROGMEM const char _dict_standard_word_252[] = "divided";
PROGMEM const uint8_t _dict_standard_code_252[] = { 174, 7, 129, 166, 157, 174, 8, 129, 176, 255 };
PROGMEM const char _dict_standard_word_253[] = "do";
PROGMEM const uint8_t _dict_standard_code_253[] = { 174, 162, 255 };
PROGMEM const char _dict_standard_word_254[] = "doctor";
PROGMEM const uint8_t _dict_standard_code_254[] = { 175, 135, 194, 191, 7, 151, 255 };
PROGMEM const char _dict_standard_word_255[] = "dodge";
PROGMEM const uint8_t _dict_standard_code_255[] = { 175, 135, 135, 177, 165, 255 };
PROGMEM const char _dict_standard_word_256[] = "doe";
PROGMEM const uint8_t _dict_standard_code_256[] = { 175, 164, 255 };
PROGMEM const char _dict_standard_word_257[] = "dog";
PROGMEM const uint8_t _dict_standard_code_257[] = { 175, 135, 135, 181, 255 };
PROGMEM const char _dict_standard_word_258[] = "doing";
PROGMEM const uint8_t _dict_standard_code_258[] = { 174, 7, 162, 8, 129, 143, 255 };
PROGMEM const char _dict_standard_word_259[] = "doll";
PROGMEM const uint8_t _dict_standard_code_259[] = { 175, 135, 135, 146, 255 };
PROGMEM const char _dict_standard_word_260[] = "dollar";
PROGMEM const uint8_t _dict_standard_code_260[] = { 175, 7, 135, 8, 145, 151, 255 };
PROGMEM const char _dict_standard_word_261[] = "dolphin";
PROGMEM const uint8_t _dict_standard_code_261[] = { 175, 135, 146, 186, 129, 141, 255 };
PROGMEM const char _dict_standard_word_262[] = "dong";
PROGMEM const uint8_t _dict_standard_code_262[] = { 175, 8, 135, 8, 144, 255 };
PROGMEM const char _dict_standard_word_263[] = "door";
PROGMEM const uint8_t _dict_standard_code_263[] = { 175, 153, 255 };
PROGMEM const char _dict_standard_word_264[] = "dot";
PROGMEM const uint8_t _dict_standard_code_264[] = { 175, 8, 135, 191, 255 };
PROGMEM const char _dict_standard_word_265[] = "double";
PROGMEM const uint8_t _dict_standard_code_265[] = { 175, 134, 173, 138, 145, 255 };
PROGMEM const char _dict_standard_word_266[] = "down";
PROGMEM const uint8_t _dict_standard_code_266[] = { 175, 163, 141, 255 };
PROGMEM const char _dict_standard_word_267[] = "dozen";
PROGMEM const uint8_t _dict_standard_code_267[] = { 174, 134, 7, 167, 130, 141, 255 };
PROGMEM const char _dict_standard_word_268[] = "dragon";
PROGMEM const uint8_t _dict_standard_code_268[] = { 175, 7, 148, 132, 7, 178, 133, 141, 255 };
PROGMEM const char _dict_standard_word_269[] = "drain";
PROGMEM const uint8_t _dict_standard_code_269[] = { 174, 7, 148, 154, 141, 255 };
PROGMEM const char _dict_standard_word_270[] = "draw";
PROGMEM const uint8_t _dict_standard_code_270[] = { 175, 7, 148, 135, 135, 255 };
PROGMEM const char _dict_standard_word_271[] = "dress";
PROGMEM const uint8_t _dict_standard_code_271[] = { 174, 7, 148, 8, 130, 187, 255 };
PROGMEM const char _dict_standard_word_272[] = "drill";
PROGMEM const uint8_t _dict_standard_code_272[] = { 174, 7, 148, 8, 129, 145, 255 };
PROGMEM const char _dict_standard_word_273[] = "drink";
PROGMEM const uint8_t _dict_standard_code_273[] = { 174, 7, 148, 15, 128, 143, 196, 255 };
PROGMEM const char _dict_standard_word_274[] = "drive";
PROGMEM const uint8_t _dict_standard_code_274[] = { 175, 7, 148, 157, 166, 255 };
PROGMEM const char _dict_standard_word_275[] = "drop";
PROGMEM const uint8_t _dict_standard_code_275[] = { 175, 7, 148, 8, 135, 7, 199, 255 };
PROGMEM const char _dict_standard_word_276[] = "drum";
PROGMEM const uint8_t _dict_standard_code_276[] = { 174, 7, 148, 8, 134, 140, 255 };
PROGMEM const char _dict_standard_word_277[] = "dry";
PROGMEM const uint8_t _dict_standard_code_277[] = { 175, 7, 148, 155, 255 };
PROGMEM const char _dict_standard_word_278[] = "duck";
PROGMEM const uint8_t _dict_standard_code_278[] = { 175, 8, 134, 194, 255 };
PROGMEM const char _dict_standard_word_279[] = "during";
PROGMEM const uint8_t _dict_standard_code_279[] = { 175, 7, 151, 8, 129, 143, 255 };
PROGMEM const char _dict_standard_word_280[] = "dusts";
PROGMEM const uint8_t _dict_standard_code_280[] = { 175, 133, 187, 4, 193, 255 };
PROGMEM const char _dict_standard_word_281[] = "dwarfs";
PROGMEM const uint8_t _dict_standard_code_281[] = { 175, 7, 147, 153, 186, 187, 255 };
PROGMEM const char _dict_standard_word_282[] = "e";
PROGMEM const uint8_t _dict_standard_code_282[] = { 128, 128, 255 };
PROGMEM const char _dict_standard_word_283[] = "each";
PROGMEM const uint8_t _dict_standard_code_283[] = { 128, 128, 4, 182, 255 };
PROGMEM const char _dict_standard_word_284[] = "eagle";
PROGMEM const uint8_t _dict_standard_code_284[] = { 128, 178, 133, 145, 255 };
PROGMEM const char _dict_standard_word_285[] = "ear";
PROGMEM const uint8_t _dict_standard_code_285[] = { 149, 148, 255 };
PROGMEM const char _dict_standard_word_286[] = "early";
PROGMEM const uint8_t _dict_standard_code_286[] = { 7, 151, 145, 7, 128, 255 };
PROGMEM const char _dict_standard_word_287[] = "earn";
PROGMEM const uint8_t _dict_standard_code_287[] = { 133, 148, 141, 255 };
PROGMEM const char _dict_standard_word_288[] = "earring";
PROGMEM const uint8_t _dict_standard_code_288[] = { 149, 7, 148, 128, 143, 255 };
PROGMEM const char _dict_standard_word_289[] = "earth";
PROGMEM const uint8_t _dict_standard_code_289[] = { 151, 190, 190, 255 };
PROGMEM const char _dict_standard_word_290[] = "easy";
PROGMEM const uint8_t _dict_standard_code_290[] = { 8, 128, 167, 7, 128, 255 };
PROGMEM const char _dict_standard_word_291[] = "eat";
PROGMEM const uint8_t _dict_standard_code_291[] = { 8, 128, 191, 255 };
PROGMEM const char _dict_standard_word_292[] = "effort";
PROGMEM const uint8_t _dict_standard_code_292[] = { 8, 131, 186, 7, 153, 191, 255 };
PROGMEM const char _dict_standard_word_293[] = "egg";
PROGMEM const uint8_t _dict_standard_code_293[] = { 8, 130, 178, 255 };
PROGMEM const char _dict_standard_word_294[] = "eight";
PROGMEM const uint8_t _dict_standard_code_294[] = { 154, 4, 191, 255 };
PROGMEM const char _dict_standard_word_295[] = "eighteen";
PROGMEM const uint8_t _dict_standard_code_295[] = { 154, 4, 191, 128, 141, 255 };
PROGMEM const char _dict_standard_word_296[] = "eighty";
PROGMEM const uint8_t _dict_standard_code_296[] = { 154, 4, 191, 128, 255 };
PROGMEM const char _dict_standard_word_297[] = "either";
PROGMEM const uint8_t _dict_standard_code_297[] = { 8, 128, 7, 169, 151, 255 };
PROGMEM const char _dict_standard_word_298[] = "elbow";
PROGMEM const uint8_t _dict_standard_code_298[] = { 131, 145, 18, 171, 164, 255 };
PROGMEM const char _dict_standard_word_299[] = "elephant";
PROGMEM const uint8_t _dict_standard_code_299[] = { 159, 7, 134, 186, 8, 133, 141, 191, 255 };
PROGMEM const char _dict_standard_word_300[] = "eleven";
PROGMEM const uint8_t _dict_standard_code_300[] = { 7, 129, 145, 131, 166, 7, 131, 141, 255 };
PROGMEM const char _dict_standard_word_301[] = "emotional";
PROGMEM const uint8_t _dict_standard_code_301[] = { 128, 140, 137, 189, 7, 133, 141, 7, 134, 145, 255 };
PROGMEM const char _dict_standard_word_302[] = "empty";
PROGMEM const uint8_t _dict_standard_code_302[] = { 130, 140, 198, 191, 128, 255 };
PROGMEM const char _dict_standard_word_303[] = "end";
PROGMEM const uint8_t _dict_standard_code_303[] = { 8, 131, 8, 141, 177, 255 };
PROGMEM const char _dict_standard_word_304[] = "engage";
PROGMEM const uint8_t _dict_standard_code_304[] = { 8, 129, 141, 4, 178, 154, 165, 255 };
PROGMEM const char _dict_standard_word_305[] = "engagement";
PROGMEM const uint8_t _dict_standard_code_305[] = { 8, 129, 141, 7, 178, 154, 165, 7, 140, 7, 130, 141, 191, 255 };
PROGMEM const char _dict_standard_word_306[] = "engages";
PROGMEM const uint8_t _dict_standard_code_306[] = { 8, 129, 141, 7, 178, 154, 165, 129, 7, 167, 255 };
PROGMEM const char _dict_standard_word_307[] = "engaging";
PROGMEM const uint8_t _dict_standard_code_307[] = { 8, 129, 141, 7, 178, 154, 165, 129, 143, 255 };
PROGMEM const char _dict_standard_word_308[] = "engine";
PROGMEM const uint8_t _dict_standard_code_308[] = { 130, 141, 7, 165, 8, 129, 141, 255 };
PROGMEM const char _dict_standard_word_309[] = "enjoy";
PROGMEM const uint8_t _dict_standard_code_309[] = { 130, 141, 7, 165, 156, 255 };
PROGMEM const char _dict_standard_word_310[] = "enough";
PROGMEM const uint8_t _dict_standard_code_310[] = { 15, 8, 128, 141, 8, 133, 186, 255 };
PROGMEM const char _dict_standard_word_311[] = "enrage";
PROGMEM const uint8_t _dict_standard_code_311[] = { 8, 129, 141, 7, 148, 154, 165, 255 };
PROGMEM const char _dict_standard_word_312[] = "enraged";
PROGMEM const uint8_t _dict_standard_code_312[] = { 8, 129, 141, 7, 148, 154, 165, 176, 255 };
PROGMEM const char _dict_standard_word_313[] = "enrages";
PROGMEM const uint8_t _dict_standard_code_313[] = { 8, 129, 141, 7, 148, 154, 165, 129, 7, 167, 255 };
PROGMEM const char _dict_standard_word_314[] = "enraging";
PROGMEM const uint8_t _dict_standard_code_314[] = { 8, 129, 141, 7, 148, 154, 165, 129, 143, 255 };
PROGMEM const char _dict_standard_word_315[] = "enter";
PROGMEM const uint8_t _dict_standard_code_315[] = { 8, 130, 141, 191, 7, 151, 255 };
PROGMEM const char _dict_standard_word_316[] = "entire";
PROGMEM const uint8_t _dict_standard_code_316[] = { 8, 130, 141, 4, 191, 157, 7, 148, 255 };
PROGMEM const char _dict_standard_word_317[] = "epsillon";
PROGMEM const uint8_t _dict_standard_code_317[] = { 131, 199, 187, 8, 129, 7, 146, 7, 135, 142, 255 };
PROGMEM const char _dict_standard_word_318[] = "equal";
PROGMEM const uint8_t _dict_standard_code_318[] = { 128, 195, 7, 147, 134, 145, 255 };
PROGMEM const char _dict_standard_word_319[] = "equals";
PROGMEM const uint8_t _dict_standard_code_319[] = { 128, 195, 7, 147, 134, 145, 7, 167, 255 };
PROGMEM const char _dict_standard_word_320[] = "erection";
PROGMEM const uint8_t _dict_standard_code_320[] = { 8, 128, 7, 148, 131, 194, 189, 133, 141, 255 };
PROGMEM const char _dict_standard_word_321[] = "error";
PROGMEM const uint8_t _dict_standard_code_321[] = { 7, 150, 153, 255 };
PROGMEM const char _dict_standard_word_322[] = "escape";
PROGMEM const uint8_t _dict_standard_code_322[] = { 131, 187, 194, 7, 154, 4, 198, 255 };
PROGMEM const char _dict_standard_word_323[] = "escaped";
PROGMEM const uint8_t _dict_standard_code_323[] = { 131, 187, 194, 7, 154, 198, 191, 255 };
PROGMEM const char _dict_standard_word_324[] = "escapes";
PROGMEM const uint8_t _dict_standard_code_324[] = { 131, 187, 194, 7, 154, 198, 187, 255 };
PROGMEM const char _dict_standard_word_325[] = "escaping";
PROGMEM const uint8_t _dict_standard_code_325[] = { 131, 187, 194, 7, 154, 198, 129, 143, 255 };
PROGMEM const char _dict_standard_word_326[] = "eta";
PROGMEM const uint8_t _dict_standard_code_326[] = { 154, 191, 7, 134, 255 };
PROGMEM const char _dict_standard_word_327[] = "even";
PROGMEM const uint8_t _dict_standard_code_327[] = { 8, 128, 166, 130, 141, 255 };
PROGMEM const char _dict_standard_word_328[] = "ever";
PROGMEM const uint8_t _dict_standard_code_328[] = { 130, 166, 7, 151, 255 };
PROGMEM const char _dict_standard_word_329[] = "every";
PROGMEM const uint8_t _dict_standard_code_329[] = { 130, 166, 148, 128, 255 };
PROGMEM const char _dict_standard_word_330[] = "extend";
PROGMEM const uint8_t _dict_standard_code_330[] = { 129, 194, 187, 191, 7, 130, 8, 141, 177, 255 };
PROGMEM const char _dict_standard_word_331[] = "extent";
PROGMEM const uint8_t _dict_standard_code_331[] = { 131, 194, 187, 191, 7, 131, 141, 191, 255 };
PROGMEM const char _dict_standard_word_332[] = "extra";
PROGMEM const uint8_t _dict_standard_code_332[] = { 130, 194, 187, 191, 7, 148, 7, 133, 255 };
PROGMEM const char _dict_standard_word_333[] = "extract";
PROGMEM const uint8_t _dict_standard_code_333[] = { 131, 194, 187, 191, 7, 148, 7, 132, 196, 191, 255 };
PROGMEM const char _dict_standard_word_334[] = "eye";
PROGMEM const uint8_t _dict_standard_code_334[] = { 155, 255 };
PROGMEM const char _dict_standard_word_335[] = "f";
PROGMEM const uint8_t _dict_standard_code_335[] = { 8, 131, 186, 255 };
PROGMEM const char _dict_standard_word_336[] = "face";
PROGMEM const uint8_t _dict_standard_code_336[] = { 186, 154, 187, 255 };
PROGMEM const char _dict_standard_word_337[] = "fah";
PROGMEM const uint8_t _dict_standard_code_337[] = { 186, 135, 135, 255 };
PROGMEM const char _dict_standard_word_338[] = "fall";
PROGMEM const uint8_t _dict_standard_code_338[] = { 186, 8, 135, 146, 255 };
PROGMEM const char _dict_standard_word_339[] = "fallen";
PROGMEM const uint8_t _dict_standard_code_339[] = { 186, 8, 135, 145, 7, 131, 141, 255 };
PROGMEM const char _dict_standard_word_340[] = "falls";
PROGMEM const uint8_t _dict_standard_code_340[] = { 186, 135, 135, 146, 187, 255 };
PROGMEM const char _dict_standard_word_341[] = "family";
PROGMEM const uint8_t _dict_standard_code_341[] = { 186, 132, 140, 7, 133, 145, 128, 255 };
PROGMEM const char _dict_standard_word_342[] = "famous";
PROGMEM const uint8_t _dict_standard_code_342[] = { 186, 154, 140, 133, 187, 255 };
PROGMEM const char _dict_standard_word_343[] = "fan";
PROGMEM const uint8_t _dict_standard_code_343[] = { 186, 132, 132, 141, 255 };
PROGMEM const char _dict_standard_word_344[] = "far";
PROGMEM const uint8_t _dict_standard_code_344[] = { 186, 152, 255 };
PROGMEM const char _dict_standard_word_345[] = "farm";
PROGMEM const uint8_t _dict_standard_code_345[] = { 186, 152, 140, 255 };
PROGMEM const char _dict_standard_word_346[] = "fart";
PROGMEM const uint8_t _dict_standard_code_346[] = { 186, 152, 191, 255 };
PROGMEM const char _dict_standard_word_347[] = "fast";
PROGMEM const uint8_t _dict_standard_code_347[] = { 186, 132, 187, 191, 255 };
PROGMEM const char _dict_standard_word_348[] = "faster";
PROGMEM const uint8_t _dict_standard_code_348[] = { 186, 132, 187, 191, 148, 255 };
PROGMEM const char _dict_standard_word_349[] = "fastest";
PROGMEM const uint8_t _dict_standard_code_349[] = { 186, 132, 187, 191, 131, 187, 191, 255 };
PROGMEM const char _dict_standard_word_350[] = "father";
PROGMEM const uint8_t _dict_standard_code_350[] = { 186, 8, 136, 169, 133, 148, 255 };
PROGMEM const char _dict_standard_word_351[] = "faucet";
PROGMEM const uint8_t _dict_standard_code_351[] = { 186, 136, 8, 187, 130, 191, 255 };
PROGMEM const char _dict_standard_word_352[] = "faucets";
PROGMEM const uint8_t _dict_standard_code_352[] = { 186, 136, 8, 187, 130, 193, 255 };
PROGMEM const char _dict_standard_word_353[] = "fault";
PROGMEM const uint8_t _dict_standard_code_353[] = { 186, 135, 135, 146, 191, 255 };
PROGMEM const char _dict_standard_word_354[] = "faults";
PROGMEM const uint8_t _dict_standard_code_354[] = { 186, 135, 135, 146, 193, 255 };
PROGMEM const char _dict_standard_word_355[] = "favorite";
PROGMEM const uint8_t _dict_standard_code_355[] = { 186, 7, 154, 166, 7, 148, 129, 191, 255 };
PROGMEM const char _dict_standard_word_356[] = "fear";
PROGMEM const uint8_t _dict_standard_code_356[] = { 186, 149, 255 };
PROGMEM const char _dict_standard_word_357[] = "fears";
PROGMEM const uint8_t _dict_standard_code_357[] = { 186, 149, 187, 255 };
PROGMEM const char _dict_standard_word_358[] = "feature";
PROGMEM const uint8_t _dict_standard_code_358[] = { 186, 128, 182, 133, 148, 255 };
PROGMEM const char _dict_standard_word_359[] = "february";
PROGMEM const uint8_t _dict_standard_code_359[] = { 186, 131, 172, 148, 139, 150, 128, 255 };
PROGMEM const char _dict_standard_word_360[] = "fed";
PROGMEM const uint8_t _dict_standard_code_360[] = { 186, 131, 131, 176, 255 };
PROGMEM const char _dict_standard_word_361[] = "feed";
PROGMEM const uint8_t _dict_standard_code_361[] = { 186, 128, 128, 176, 255 };
PROGMEM const char _dict_standard_word_362[] = "feeding";
PROGMEM const uint8_t _dict_standard_code_362[] = { 186, 128, 128, 174, 129, 143, 255 };
PROGMEM const char _dict_standard_word_363[] = "feeds";
PROGMEM const uint8_t _dict_standard_code_363[] = { 186, 128, 128, 174, 167, 255 };
PROGMEM const char _dict_standard_word_364[] = "feel";
PROGMEM const uint8_t _dict_standard_code_364[] = { 8, 186, 8, 128, 146, 255 };
PROGMEM const char _dict_standard_word_365[] = "feet";
PROGMEM const uint8_t _dict_standard_code_365[] = { 186, 128, 191, 255 };
PROGMEM const char _dict_standard_word_366[] = "fence";
PROGMEM const uint8_t _dict_standard_code_366[] = { 186, 130, 141, 188, 188, 255 };
PROGMEM const char _dict_standard_word_367[] = "fern";
PROGMEM const uint8_t _dict_standard_code_367[] = { 186, 151, 141, 255 };
PROGMEM const char _dict_standard_word_368[] = "few";
PROGMEM const uint8_t _dict_standard_code_368[] = { 186, 160, 255 };
PROGMEM const char _dict_standard_word_369[] = "fibber";
PROGMEM const uint8_t _dict_standard_code_369[] = { 8, 186, 129, 18, 171, 8, 148, 255 };
PROGMEM const char _dict_standard_word_370[] = "fiction";
PROGMEM const uint8_t _dict_standard_code_370[] = { 186, 129, 194, 189, 133, 141, 255 };
PROGMEM const char _dict_standard_word_371[] = "field";
PROGMEM const uint8_t _dict_standard_code_371[] = { 186, 8, 128, 145, 174, 255 };
PROGMEM const char _dict_standard_word_372[] = "fifteen";
PROGMEM const uint8_t _dict_standard_code_372[] = { 186, 129, 186, 191, 128, 141, 255 };
PROGMEM const char _dict_standard_word_373[] = "fifty";
PROGMEM const uint8_t _dict_standard_code_373[] = { 186, 129, 186, 191, 128, 255 };
PROGMEM const char _dict_standard_word_374[] = "fight";
PROGMEM const uint8_t _dict_standard_code_374[] = { 8, 186, 7, 155, 4, 191, 255 };
PROGMEM const char _dict_standard_word_375[] = "fighter";
PROGMEM const uint8_t _dict_standard_code_375[] = { 186, 155, 191, 148, 255 };
PROGMEM const char _dict_standard_word_376[] = "fighting";
PROGMEM const uint8_t _dict_standard_code_376[] = { 186, 155, 191, 129, 143, 255 };
PROGMEM const char _dict_standard_word_377[] = "fights";
PROGMEM const uint8_t _dict_standard_code_377[] = { 186, 155, 193, 255 };
PROGMEM const char _dict_standard_word_378[] = "fill";
PROGMEM const uint8_t _dict_standard_code_378[] = { 186, 8, 15, 129, 145, 255 };
PROGMEM const char _dict_standard_word_379[] = "finally";
PROGMEM const uint8_t _dict_standard_code_379[] = { 186, 7, 155, 142, 7, 145, 128, 255 };
PROGMEM const char _dict_standard_word_380[] = "find";
PROGMEM const uint8_t _dict_standard_code_380[] = { 186, 155, 141, 177, 255 };
PROGMEM const char _dict_standard_word_381[] = "finger";
PROGMEM const uint8_t _dict_standard_code_381[] = { 186, 129, 7, 143, 178, 151, 255 };
PROGMEM const char _dict_standard_word_382[] = "fir";
PROGMEM const uint8_t _dict_standard_code_382[] = { 186, 151, 255 };
PROGMEM const char _dict_standard_word_383[] = "fire";
PROGMEM const uint8_t _dict_standard_code_383[] = { 186, 155, 148, 255 };
PROGMEM const char _dict_standard_word_384[] = "first";
PROGMEM const uint8_t _dict_standard_code_384[] = { 186, 151, 187, 191, 255 };
PROGMEM const char _dict_standard_word_385[] = "fish";
PROGMEM const uint8_t _dict_standard_code_385[] = { 186, 129, 129, 189, 189, 255 };
PROGMEM const char _dict_standard_word_386[] = "fist";
PROGMEM const uint8_t _dict_standard_code_386[] = { 186, 129, 129, 187, 191, 255 };
PROGMEM const char _dict_standard_word_387[] = "fit";
PROGMEM const uint8_t _dict_standard_code_387[] = { 186, 129, 191, 255 };
PROGMEM const char _dict_standard_word_388[] = "five";
PROGMEM const uint8_t _dict_standard_code_388[] = { 186, 157, 166, 255 };
PROGMEM const char _dict_standard_word_389[] = "fix";
PROGMEM const uint8_t _dict_standard_code_389[] = { 186, 129, 194, 187, 255 };
PROGMEM const char _dict_standard_word_390[] = "fixed";
PROGMEM const uint8_t _dict_standard_code_390[] = { 186, 129, 194, 187, 191, 255 };
PROGMEM const char _dict_standard_word_391[] = "flag";
PROGMEM const uint8_t _dict_standard_code_391[] = { 186, 145, 132, 132, 180, 255 };
PROGMEM const char _dict_standard_word_392[] = "flat";
PROGMEM const uint8_t _dict_standard_code_392[] = { 186, 145, 132, 191, 255 };
PROGMEM const char _dict_standard_word_393[] = "flight";
PROGMEM const uint8_t _dict_standard_code_393[] = { 186, 145, 155, 191, 255 };
PROGMEM const char _dict_standard_word_394[] = "flights";
PROGMEM const uint8_t _dict_standard_code_394[] = { 186, 145, 155, 193, 255 };
PROGMEM const char _dict_standard_word_395[] = "float";
PROGMEM const uint8_t _dict_standard_code_395[] = { 186, 145, 164, 191, 255 };
PROGMEM const char _dict_standard_word_396[] = "floor";
PROGMEM const uint8_t _dict_standard_code_396[] = { 186, 146, 153, 255 };
PROGMEM const char _dict_standard_word_397[] = "flour";
PROGMEM const uint8_t _dict_standard_code_397[] = { 186, 146, 163, 148, 255 };
PROGMEM const char _dict_standard_word_398[] = "flower";
PROGMEM const uint8_t _dict_standard_code_398[] = { 186, 146, 163, 148, 255 };
PROGMEM const char _dict_standard_word_399[] = "fly";
PROGMEM const uint8_t _dict_standard_code_399[] = { 186, 146, 155, 255 };
PROGMEM const char _dict_standard_word_400[] = "follow";
PROGMEM const uint8_t _dict_standard_code_400[] = { 186, 136, 146, 164, 255 };
PROGMEM const char _dict_standard_word_401[] = "food";
PROGMEM const uint8_t _dict_standard_code_401[] = { 186, 139, 139, 174, 255 };
PROGMEM const char _dict_standard_word_402[] = "fool";
PROGMEM const uint8_t _dict_standard_code_402[] = { 186, 139, 139, 146, 255 };
PROGMEM const char _dict_standard_word_403[] = "foot";
PROGMEM const uint8_t _dict_standard_code_403[] = { 186, 8, 138, 191, 255 };
PROGMEM const char _dict_standard_word_404[] = "football";
PROGMEM const uint8_t _dict_standard_code_404[] = { 186, 8, 138, 191, 7, 4, 18, 171, 135, 8, 146, 255 };
PROGMEM const char _dict_standard_word_405[] = "for";
PROGMEM const uint8_t _dict_standard_code_405[] = { 186, 153, 255 };
PROGMEM const char _dict_standard_word_406[] = "fore";
PROGMEM const uint8_t _dict_standard_code_406[] = { 186, 153, 255 };
PROGMEM const char _dict_standard_word_407[] = "foreign";
PROGMEM const uint8_t _dict_standard_code_407[] = { 186, 153, 7, 129, 141, 255 };
PROGMEM const char _dict_standard_word_408[] = "forest";
PROGMEM const uint8_t _dict_standard_code_408[] = { 186, 153, 7, 131, 187, 191, 255 };
PROGMEM const char _dict_standard_word_409[] = "forget";
PROGMEM const uint8_t _dict_standard_code_409[] = { 186, 7, 153, 178, 14, 131, 191, 255 };
PROGMEM const char _dict_standard_word_410[] = "fork";
PROGMEM const uint8_t _dict_standard_code_410[] = { 186, 153, 194, 255 };
PROGMEM const char _dict_standard_word_411[] = "forks";
PROGMEM const uint8_t _dict_standard_code_411[] = { 186, 153, 194, 187, 255 };
PROGMEM const char _dict_standard_word_412[] = "form";
PROGMEM const uint8_t _dict_standard_code_412[] = { 186, 153, 140, 255 };
PROGMEM const char _dict_standard_word_413[] = "fort";
PROGMEM const uint8_t _dict_standard_code_413[] = { 186, 153, 191, 255 };
PROGMEM const char _dict_standard_word_414[] = "forth";
PROGMEM const uint8_t _dict_standard_code_414[] = { 186, 153, 190, 255 };
PROGMEM const char _dict_standard_word_415[] = "forties";
PROGMEM const uint8_t _dict_standard_code_415[] = { 186, 153, 191, 128, 7, 167, 255 };
PROGMEM const char _dict_standard_word_416[] = "forts";
PROGMEM const uint8_t _dict_standard_code_416[] = { 186, 153, 193, 255 };
PROGMEM const char _dict_standard_word_417[] = "fortune";
PROGMEM const uint8_t _dict_standard_code_417[] = { 186, 153, 182, 133, 141, 255 };
PROGMEM const char _dict_standard_word_418[] = "forty";
PROGMEM const uint8_t _dict_standard_code_418[] = { 186, 7, 153, 191, 128, 255 };
PROGMEM const char _dict_standard_word_419[] = "forward";
PROGMEM const uint8_t _dict_standard_code_419[] = { 186, 7, 153, 7, 147, 151, 176, 255 };
PROGMEM const char _dict_standard_word_420[] = "four";
PROGMEM const uint8_t _dict_standard_code_420[] = { 186, 7, 137, 153, 255 };
PROGMEM const char _dict_standard_word_421[] = "fourteen";
PROGMEM const uint8_t _dict_standard_code_421[] = { 186, 7, 153, 7, 191, 128, 141, 255 };
PROGMEM const char _dict_standard_word_422[] = "fox";
PROGMEM const uint8_t _dict_standard_code_422[] = { 186, 8, 135, 195, 187, 255 };
PROGMEM const char _dict_standard_word_423[] = "free";
PROGMEM const uint8_t _dict_standard_code_423[] = { 8, 186, 148, 8, 128, 255 };
PROGMEM const char _dict_standard_word_424[] = "freeze";
PROGMEM const uint8_t _dict_standard_code_424[] = { 186, 148, 128, 167, 255 };
PROGMEM const char _dict_standard_word_425[] = "freezer";
PROGMEM const uint8_t _dict_standard_code_425[] = { 186, 148, 128, 167, 7, 151, 255 };
PROGMEM const char _dict_standard_word_426[] = "freezers";
PROGMEM const uint8_t _dict_standard_code_426[] = { 186, 148, 128, 167, 7, 151, 167, 255 };
PROGMEM const char _dict_standard_word_427[] = "freezing";
PROGMEM const uint8_t _dict_standard_code_427[] = { 186, 148, 128, 167, 129, 143, 255 };
PROGMEM const char _dict_standard_word_428[] = "friday";
PROGMEM const uint8_t _dict_standard_code_428[] = { 186, 148, 155, 174, 154, 255 };
PROGMEM const char _dict_standard_word_429[] = "friend";
PROGMEM const uint8_t _dict_standard_code_429[] = { 186, 148, 131, 141, 175, 255 };
PROGMEM const char _dict_standard_word_430[] = "fright";
PROGMEM const uint8_t _dict_standard_code_430[] = { 186, 148, 155, 191, 255 };
PROGMEM const char _dict_standard_word_431[] = "frog";
PROGMEM const uint8_t _dict_standard_code_431[] = { 186, 148, 135, 8, 181, 255 };
PROGMEM const char _dict_standard_word_432[] = "from";
PROGMEM const uint8_t _dict_standard_code_432[] = { 186, 148, 134, 8, 140, 255 };
PROGMEM const char _dict_standard_word_433[] = "front";
PROGMEM const uint8_t _dict_standard_code_433[] = { 186, 148, 134, 141, 191, 255 };
PROGMEM const char _dict_standard_word_434[] = "frozen";
PROGMEM const uint8_t _dict_standard_code_434[] = { 186, 148, 137, 167, 131, 141, 255 };
PROGMEM const char _dict_standard_word_435[] = "fruit";
PROGMEM const uint8_t _dict_standard_code_435[] = { 186, 148, 139, 191, 255 };
PROGMEM const char _dict_standard_word_436[] = "full";
PROGMEM const uint8_t _dict_standard_code_436[] = { 186, 15, 138, 15, 138, 146, 255 };
PROGMEM const char _dict_standard_word_437[] = "fun";
PROGMEM const uint8_t _dict_standard_code_437[] = { 186, 8, 134, 141, 255 };
PROGMEM const char _dict_standard_word_438[] = "funny";
PROGMEM const uint8_t _dict_standard_code_438[] = { 186, 8, 134, 7, 141, 128, 255 };
PROGMEM const char _dict_standard_word_439[] = "fur";
PROGMEM const uint8_t _dict_standard_code_439[] = { 186, 151, 255 };
PROGMEM const char _dict_standard_word_440[] = "furniture";
PROGMEM const uint8_t _dict_standard_code_440[] = { 186, 7, 151, 141, 7, 129, 182, 7, 151, 255 };
PROGMEM const char _dict_standard_word_441[] = "fxalarm";
PROGMEM const uint8_t _dict_standard_code_441[] = { 30, 26, 3, 217, 26, 3, 216, 26, 3, 214, 26, 3, 213, 211, 26, 3, 210, 30, 255 };
PROGMEM const char _dict_standard_word_442[] = "fxburningfusewithbang";
PROGMEM const uint8_t _dict_standard_code_442[] = { 30, 21, 114, 182, 1, 182, 1, 182, 21, 0, 26, 6, 189, 187, 253, 30, 255 };
PROGMEM const char _dict_standard_word_443[] = "fxping";
PROGMEM const uint8_t _dict_standard_code_443[] = { 30, 21, 50, 23, 0, 252, 252, 252, 30, 255 };
PROGMEM const char _dict_standard_word_444[] = "fxrobotbede";
PROGMEM const uint8_t _dict_standard_code_444[] = { 30, 21, 127, 170, 128, 174, 128, 170, 128, 174, 128, 170, 128, 174, 128, 170, 128, 174, 128, 170, 128, 174, 128, 30, 255 };
PROGMEM const char _dict_standard_word_445[] = "fxrobotdroid";
PROGMEM const uint8_t _dict_standard_code_445[] = { 30, 223, 4, 222, 5, 207, 200, 207, 202, 207, 204, 207, 206, 208, 203, 203, 203, 4, 226, 4, 226, 4, 238, 4, 239, 255 };
PROGMEM const char _dict_standard_word_446[] = "fxrobotsad";
PROGMEM const uint8_t _dict_standard_code_446[] = { 30, 23, 0, 21, 61, 228, 1, 223, 220, 1, 239, 1, 30, 255 };
PROGMEM const char _dict_standard_word_447[] = "fxstatus1";
PROGMEM const uint8_t _dict_standard_code_447[] = { 30, 226, 3, 226, 3, 226, 3, 227, 220, 30, 255 };
PROGMEM const char _dict_standard_word_448[] = "fxstatus2";
PROGMEM const uint8_t _dict_standard_code_448[] = { 30, 220, 2, 220, 2, 220, 2, 226, 2, 220, 2, 226, 255 };
PROGMEM const char _dict_standard_word_449[] = "fxufo";
PROGMEM const uint8_t _dict_standard_code_449[] = { 30, 26, 5, 215, 255 };
PROGMEM const char _dict_standard_word_450[] = "g";
PROGMEM const uint8_t _dict_standard_code_450[] = { 165, 128, 128, 255 };
PROGMEM const char _dict_standard_word_451[] = "game";
PROGMEM const uint8_t _dict_standard_code_451[] = { 8, 178, 154, 140, 255 };
PROGMEM const char _dict_standard_word_452[] = "gamma";
PROGMEM const uint8_t _dict_standard_code_452[] = { 8, 178, 132, 140, 134, 255 };
PROGMEM const char _dict_standard_word_453[] = "garden";
PROGMEM const uint8_t _dict_standard_code_453[] = { 179, 136, 7, 148, 7, 174, 131, 141, 255 };
PROGMEM const char _dict_standard_word_454[] = "garment";
PROGMEM const uint8_t _dict_standard_code_454[] = { 179, 7, 152, 140, 131, 141, 191, 255 };
PROGMEM const char _dict_standard_word_455[] = "gate";
PROGMEM const uint8_t _dict_standard_code_455[] = { 8, 178, 154, 191, 255 };
PROGMEM const char _dict_standard_word_456[] = "gates";
PROGMEM const uint8_t _dict_standard_code_456[] = { 8, 178, 154, 8, 193, 255 };
PROGMEM const char _dict_standard_word_457[] = "gauge";
PROGMEM const uint8_t _dict_standard_code_457[] = { 8, 178, 154, 165, 255 };
PROGMEM const char _dict_standard_word_458[] = "gentlemen";
PROGMEM const uint8_t _dict_standard_code_458[] = { 165, 7, 131, 141, 191, 145, 140, 131, 8, 141, 255 };
PROGMEM const char _dict_standard_word_459[] = "get";
PROGMEM const uint8_t _dict_standard_code_459[] = { 8, 178, 8, 131, 191, 255 };
PROGMEM const char _dict_standard_word_460[] = "giant";
PROGMEM const uint8_t _dict_standard_code_460[] = { 165, 155, 7, 130, 141, 191, 255 };
PROGMEM const char _dict_standard_word_461[] = "gift";
PROGMEM const uint8_t _dict_standard_code_461[] = { 8, 178, 129, 186, 191, 255 };
PROGMEM const char _dict_standard_word_462[] = "giraffe";
PROGMEM const uint8_t _dict_standard_code_462[] = { 165, 7, 151, 8, 132, 186, 255 };
PROGMEM const char _dict_standard_word_463[] = "girl";
PROGMEM const uint8_t _dict_standard_code_463[] = { 8, 178, 7, 151, 7, 148, 8, 146, 255 };
PROGMEM const char _dict_standard_word_464[] = "give";
PROGMEM const uint8_t _dict_standard_code_464[] = { 8, 178, 8, 129, 7, 166, 255 };
PROGMEM const char _dict_standard_word_465[] = "glad";
PROGMEM const uint8_t _dict_standard_code_465[] = { 8, 179, 7, 145, 8, 132, 176, 255 };
PROGMEM const char _dict_standard_word_466[] = "glass";
PROGMEM const uint8_t _dict_standard_code_466[] = { 8, 179, 7, 145, 8, 132, 187, 255 };
PROGMEM const char _dict_standard_word_467[] = "glasses";
PROGMEM const uint8_t _dict_standard_code_467[] = { 8, 179, 7, 145, 8, 132, 187, 7, 18, 131, 7, 167, 255 };
PROGMEM const char _dict_standard_word_468[] = "glove";
PROGMEM const uint8_t _dict_standard_code_468[] = { 8, 179, 7, 146, 134, 8, 166, 255 };
PROGMEM const char _dict_standard_word_469[] = "glue";
PROGMEM const uint8_t _dict_standard_code_469[] = { 8, 179, 7, 146, 162, 255 };
PROGMEM const char _dict_standard_word_470[] = "go";
PROGMEM const uint8_t _dict_standard_code_470[] = { 8, 179, 8, 164, 255 };
PROGMEM const char _dict_standard_word_471[] = "goat";
PROGMEM const uint8_t _dict_standard_code_471[] = { 8, 179, 164, 191, 255 };
PROGMEM const char _dict_standard_word_472[] = "gong";
PROGMEM const uint8_t _dict_standard_code_472[] = { 8, 179, 8, 135, 144, 255 };
PROGMEM const char _dict_standard_word_473[] = "good";
PROGMEM const uint8_t _dict_standard_code_473[] = { 8, 179, 138, 138, 177, 255 };
PROGMEM const char _dict_standard_word_474[] = "goodbye";
PROGMEM const uint8_t _dict_standard_code_474[] = { 8, 179, 139, 177, 7, 4, 18, 171, 157, 255 };
PROGMEM const char _dict_standard_word_475[] = "goose";
PROGMEM const uint8_t _dict_standard_code_475[] = { 8, 179, 8, 139, 187, 255 };
PROGMEM const char _dict_standard_word_476[] = "got";
PROGMEM const uint8_t _dict_standard_code_476[] = { 8, 179, 135, 135, 191, 255 };
PROGMEM const char _dict_standard_word_477[] = "grand";
PROGMEM const uint8_t _dict_standard_code_477[] = { 8, 178, 7, 148, 132, 141, 177, 255 };
PROGMEM const char _dict_standard_word_478[] = "grandfather";
PROGMEM const uint8_t _dict_standard_code_478[] = { 8, 178, 7, 148, 132, 141, 175, 186, 8, 136, 169, 133, 148, 255 };
PROGMEM const char _dict_standard_word_479[] = "grandmother";
PROGMEM const uint8_t _dict_standard_code_479[] = { 8, 178, 7, 148, 132, 141, 176, 140, 134, 190, 151, 255 };
PROGMEM const char _dict_standard_word_480[] = "grape";
PROGMEM const uint8_t _dict_standard_code_480[] = { 8, 178, 7, 148, 154, 199, 255 };
PROGMEM const char _dict_standard_word_481[] = "grapefruit";
PROGMEM const uint8_t _dict_standard_code_481[] = { 8, 178, 7, 148, 154, 199, 186, 7, 148, 139, 191, 255 };
PROGMEM const char _dict_standard_word_482[] = "grass";
PROGMEM const uint8_t _dict_standard_code_482[] = { 8, 179, 7, 148, 8, 132, 187, 187, 255 };
PROGMEM const char _dict_standard_word_483[] = "grasshopper";
PROGMEM const uint8_t _dict_standard_code_483[] = { 8, 179, 7, 148, 132, 187, 184, 135, 199, 7, 151, 255 };
PROGMEM const char _dict_standard_word_484[] = "gray";
PROGMEM const uint8_t _dict_standard_code_484[] = { 8, 179, 7, 148, 8, 154, 255 };
PROGMEM const char _dict_standard_word_485[] = "grease";
PROGMEM const uint8_t _dict_standard_code_485[] = { 8, 179, 7, 148, 8, 128, 187, 255 };
PROGMEM const char _dict_standard_word_486[] = "great";
PROGMEM const uint8_t _dict_standard_code_486[] = { 8, 179, 7, 148, 154, 191, 255 };
PROGMEM const char _dict_standard_word_487[] = "green";
PROGMEM const uint8_t _dict_standard_code_487[] = { 8, 179, 7, 148, 8, 128, 141, 255 };
PROGMEM const char _dict_standard_word_488[] = "grey";
PROGMEM const uint8_t _dict_standard_code_488[] = { 8, 179, 7, 148, 154, 255 };
PROGMEM const char _dict_standard_word_489[] = "ground";
PROGMEM const uint8_t _dict_standard_code_489[] = { 8, 179, 7, 148, 132, 7, 163, 7, 141, 177, 255 };
PROGMEM const char _dict_standard_word_490[] = "group";
PROGMEM const uint8_t _dict_standard_code_490[] = { 8, 179, 7, 148, 139, 139, 199, 255 };
PROGMEM const char _dict_standard_word_491[] = "grow";
PROGMEM const uint8_t _dict_standard_code_491[] = { 8, 179, 7, 148, 137, 164, 255 };
PROGMEM const char _dict_standard_word_492[] = "guaged";
PROGMEM const uint8_t _dict_standard_code_492[] = { 8, 178, 154, 165, 18, 174, 255 };
PROGMEM const char _dict_standard_word_493[] = "guages";
PROGMEM const uint8_t _dict_standard_code_493[] = { 8, 178, 154, 165, 129, 167, 255 };
PROGMEM const char _dict_standard_word_494[] = "guaging";
PROGMEM const uint8_t _dict_standard_code_494[] = { 8, 178, 154, 165, 129, 143, 255 };
PROGMEM const char _dict_standard_word_495[] = "guest";
PROGMEM const uint8_t _dict_standard_code_495[] = { 8, 178, 131, 131, 187, 191, 255 };
PROGMEM const char _dict_standard_word_496[] = "h";
PROGMEM const uint8_t _dict_standard_code_496[] = { 154, 182, 255 };
PROGMEM const char _dict_standard_word_497[] = "hair";
PROGMEM const uint8_t _dict_standard_code_497[] = { 183, 130, 150, 255 };
PROGMEM const char _dict_standard_word_498[] = "half";
PROGMEM const uint8_t _dict_standard_code_498[] = { 184, 8, 132, 186, 255 };
PROGMEM const char _dict_standard_word_499[] = "hammer";
PROGMEM const uint8_t _dict_standard_code_499[] = { 183, 132, 140, 151, 255 };
PROGMEM const char _dict_standard_word_500[] = "hand";
PROGMEM const uint8_t _dict_standard_code_500[] = { 183, 132, 8, 141, 177, 255 };
PROGMEM const char _dict_standard_word_501[] = "handle";
PROGMEM const uint8_t _dict_standard_code_501[] = { 183, 8, 132, 141, 7, 174, 7, 133, 8, 145, 255 };
PROGMEM const char _dict_standard_word_502[] = "handstands";
PROGMEM const uint8_t _dict_standard_code_502[] = { 183, 132, 141, 174, 187, 191, 132, 141, 176, 187, 255 };
PROGMEM const char _dict_standard_word_503[] = "happen";
PROGMEM const uint8_t _dict_standard_code_503[] = { 183, 132, 199, 131, 141, 255 };
PROGMEM const char _dict_standard_word_504[] = "happy";
PROGMEM const uint8_t _dict_standard_code_504[] = { 183, 132, 198, 128, 255 };
PROGMEM const char _dict_standard_word_505[] = "hard";
PROGMEM const uint8_t _dict_standard_code_505[] = { 184, 152, 177, 255 };
PROGMEM const char _dict_standard_word_506[] = "hat";
PROGMEM const uint8_t _dict_standard_code_506[] = { 183, 8, 132, 191, 255 };
PROGMEM const char _dict_standard_word_507[] = "have";
PROGMEM const uint8_t _dict_standard_code_507[] = { 183, 8, 132, 166, 255 };
PROGMEM const char _dict_standard_word_508[] = "he";
PROGMEM const uint8_t _dict_standard_code_508[] = { 183, 128, 255 };
PROGMEM const char _dict_standard_word_509[] = "head";
PROGMEM const uint8_t _dict_standard_code_509[] = { 183, 8, 131, 174, 255 };
PROGMEM const char _dict_standard_word_510[] = "health";
PROGMEM const uint8_t _dict_standard_code_510[] = { 183, 8, 131, 145, 8, 190, 255 };
PROGMEM const char _dict_standard_word_511[] = "hear";
PROGMEM const uint8_t _dict_standard_code_511[] = { 183, 149, 255 };
PROGMEM const char _dict_standard_word_512[] = "heart";
PROGMEM const uint8_t _dict_standard_code_512[] = { 183, 152, 191, 255 };
PROGMEM const char _dict_standard_word_513[] = "heat";
PROGMEM const uint8_t _dict_standard_code_513[] = { 183, 8, 128, 191, 255 };
PROGMEM const char _dict_standard_word_514[] = "heavy";
PROGMEM const uint8_t _dict_standard_code_514[] = { 183, 131, 166, 128, 255 };
PROGMEM const char _dict_standard_word_515[] = "hell";
PROGMEM const uint8_t _dict_standard_code_515[] = { 183, 131, 145, 145, 255 };
PROGMEM const char _dict_standard_word_516[] = "hello";
PROGMEM const uint8_t _dict_standard_code_516[] = { 183, 7, 159, 146, 164, 255 };
PROGMEM const char _dict_standard_word_517[] = "help";
PROGMEM const uint8_t _dict_standard_code_517[] = { 183, 159, 199, 255 };
PROGMEM const char _dict_standard_word_518[] = "her";
PROGMEM const uint8_t _dict_standard_code_518[] = { 183, 151, 255 };
PROGMEM const char _dict_standard_word_519[] = "here";
PROGMEM const uint8_t _dict_standard_code_519[] = { 183, 149, 255 };
PROGMEM const char _dict_standard_word_520[] = "hers";
PROGMEM const uint8_t _dict_standard_code_520[] = { 183, 7, 151, 167, 255 };
PROGMEM const char _dict_standard_word_521[] = "herself";
PROGMEM const uint8_t _dict_standard_code_521[] = { 183, 7, 151, 187, 131, 146, 186, 255 };
PROGMEM const char _dict_standard_word_522[] = "hex";
PROGMEM const uint8_t _dict_standard_code_522[] = { 183, 8, 131, 194, 187, 255 };
PROGMEM const char _dict_standard_word_523[] = "hexagon";
PROGMEM const uint8_t _dict_standard_code_523[] = { 183, 131, 194, 187, 7, 133, 179, 135, 142, 255 };
PROGMEM const char _dict_standard_word_524[] = "hi";
PROGMEM const uint8_t _dict_standard_code_524[] = { 184, 155, 255 };
PROGMEM const char _dict_standard_word_525[] = "hide";
PROGMEM const uint8_t _dict_standard_code_525[] = { 184, 155, 4, 8, 176, 255 };
PROGMEM const char _dict_standard_word_526[] = "high";
PROGMEM const uint8_t _dict_standard_code_526[] = { 184, 155, 255 };
PROGMEM const char _dict_standard_word_527[] = "him";
PROGMEM const uint8_t _dict_standard_code_527[] = { 183, 8, 129, 140, 255 };
PROGMEM const char _dict_standard_word_528[] = "himself";
PROGMEM const uint8_t _dict_standard_code_528[] = { 183, 129, 140, 187, 131, 146, 186, 255 };
PROGMEM const char _dict_standard_word_529[] = "his";
PROGMEM const uint8_t _dict_standard_code_529[] = { 183, 129, 167, 255 };
PROGMEM const char _dict_standard_word_530[] = "hit";
PROGMEM const uint8_t _dict_standard_code_530[] = { 183, 129, 191, 255 };
PROGMEM const char _dict_standard_word_531[] = "hobbies";
PROGMEM const uint8_t _dict_standard_code_531[] = { 184, 135, 7, 170, 8, 128, 7, 187, 255 };
PROGMEM const char _dict_standard_word_532[] = "hobby";
PROGMEM const uint8_t _dict_standard_code_532[] = { 184, 135, 7, 170, 8, 128, 255 };
PROGMEM const char _dict_standard_word_533[] = "hoe";
PROGMEM const uint8_t _dict_standard_code_533[] = { 183, 137, 164, 255 };
PROGMEM const char _dict_standard_word_534[] = "hold";
PROGMEM const uint8_t _dict_standard_code_534[] = { 184, 137, 8, 146, 177, 255 };
PROGMEM const char _dict_standard_word_535[] = "hole";
PROGMEM const uint8_t _dict_standard_code_535[] = { 184, 164, 8, 146, 255 };
PROGMEM const char _dict_standard_word_536[] = "holiday";
PROGMEM const uint8_t _dict_standard_code_536[] = { 184, 135, 145, 129, 174, 154, 255 };
PROGMEM const char _dict_standard_word_537[] = "hollow";
PROGMEM const uint8_t _dict_standard_code_537[] = { 184, 135, 146, 7, 137, 7, 164, 255 };
PROGMEM const char _dict_standard_word_538[] = "home";
PROGMEM const uint8_t _dict_standard_code_538[] = { 184, 137, 137, 8, 140, 255 };
PROGMEM const char _dict_standard_word_539[] = "honest";
PROGMEM const uint8_t _dict_standard_code_539[] = { 135, 141, 131, 187, 191, 255 };
PROGMEM const char _dict_standard_word_540[] = "honey";
PROGMEM const uint8_t _dict_standard_code_540[] = { 184, 134, 141, 128, 255 };
PROGMEM const char _dict_standard_word_541[] = "hook";
PROGMEM const uint8_t _dict_standard_code_541[] = { 184, 138, 197, 255 };
PROGMEM const char _dict_standard_word_542[] = "hop";
PROGMEM const uint8_t _dict_standard_code_542[] = { 184, 135, 199, 255 };
PROGMEM const char _dict_standard_word_543[] = "horn";
PROGMEM const uint8_t _dict_standard_code_543[] = { 184, 153, 141, 255 };
PROGMEM const char _dict_standard_word_544[] = "horse";
PROGMEM const uint8_t _dict_standard_code_544[] = { 184, 153, 187, 255 };
PROGMEM const char _dict_standard_word_545[] = "hot";
PROGMEM const uint8_t _dict_standard_code_545[] = { 183, 135, 191, 255 };
PROGMEM const char _dict_standard_word_546[] = "hour";
PROGMEM const uint8_t _dict_standard_code_546[] = { 163, 148, 255 };
PROGMEM const char _dict_standard_word_547[] = "house";
PROGMEM const uint8_t _dict_standard_code_547[] = { 184, 163, 187, 255 };
PROGMEM const char _dict_standard_word_548[] = "how";
PROGMEM const uint8_t _dict_standard_code_548[] = { 184, 8, 163, 255 };
PROGMEM const char _dict_standard_word_549[] = "hug";
PROGMEM const uint8_t _dict_standard_code_549[] = { 184, 8, 134, 8, 181, 255 };
PROGMEM const char _dict_standard_word_550[] = "human";
PROGMEM const uint8_t _dict_standard_code_550[] = { 183, 7, 160, 140, 131, 141, 255 };
PROGMEM const char _dict_standard_word_551[] = "humaniod";
PROGMEM const uint8_t _dict_standard_code_551[] = { 184, 7, 160, 140, 134, 7, 142, 7, 137, 7, 156, 176, 255 };
PROGMEM const char _dict_standard_word_552[] = "hundred";
PROGMEM const uint8_t _dict_standard_code_552[] = { 184, 134, 141, 176, 7, 148, 131, 176, 255 };
PROGMEM const char _dict_standard_word_553[] = "hung";
PROGMEM const uint8_t _dict_standard_code_553[] = { 183, 8, 134, 8, 144, 255 };
PROGMEM const char _dict_standard_word_554[] = "hunger";
PROGMEM const uint8_t _dict_standard_code_554[] = { 184, 134, 7, 143, 178, 148, 255 };
PROGMEM const char _dict_standard_word_555[] = "hungry";
PROGMEM const uint8_t _dict_standard_code_555[] = { 184, 134, 143, 178, 7, 148, 128, 255 };
PROGMEM const char _dict_standard_word_556[] = "hurry";
PROGMEM const uint8_t _dict_standard_code_556[] = { 184, 151, 128, 255 };
PROGMEM const char _dict_standard_word_557[] = "hurt";
PROGMEM const uint8_t _dict_standard_code_557[] = { 184, 151, 191, 255 };
PROGMEM const char _dict_standard_word_558[] = "i";
PROGMEM const uint8_t _dict_standard_code_558[] = { 157, 255 };
PROGMEM const char _dict_standard_word_559[] = "ice";
PROGMEM const uint8_t _dict_standard_code_559[] = { 155, 187, 187, 255 };
PROGMEM const char _dict_standard_word_560[] = "icecream";
PROGMEM const uint8_t _dict_standard_code_560[] = { 7, 155, 7, 128, 8, 187, 7, 4, 194, 148, 128, 140, 255 };
PROGMEM const char _dict_standard_word_561[] = "if";
PROGMEM const uint8_t _dict_standard_code_561[] = { 129, 186, 186, 255 };
PROGMEM const char _dict_standard_word_562[] = "ill";
PROGMEM const uint8_t _dict_standard_code_562[] = { 129, 146, 255 };
PROGMEM const char _dict_standard_word_563[] = "in";
PROGMEM const uint8_t _dict_standard_code_563[] = { 8, 129, 8, 141, 255 };
PROGMEM const char _dict_standard_word_564[] = "infinitive";
PROGMEM const uint8_t _dict_standard_code_564[] = { 8, 129, 7, 141, 8, 186, 129, 141, 129, 191, 129, 166, 255 };
PROGMEM const char _dict_standard_word_565[] = "injure";
PROGMEM const uint8_t _dict_standard_code_565[] = { 8, 129, 141, 165, 7, 151, 255 };
PROGMEM const char _dict_standard_word_566[] = "innovate";
PROGMEM const uint8_t _dict_standard_code_566[] = { 8, 129, 141, 7, 137, 166, 154, 191, 255 };
PROGMEM const char _dict_standard_word_567[] = "innovations";
PROGMEM const uint8_t _dict_standard_code_567[] = { 8, 129, 141, 7, 137, 166, 7, 154, 189, 133, 142, 187, 255 };
PROGMEM const char _dict_standard_word_568[] = "insect";
PROGMEM const uint8_t _dict_standard_code_568[] = { 129, 141, 187, 131, 194, 191, 255 };
PROGMEM const char _dict_standard_word_569[] = "inside";
PROGMEM const uint8_t _dict_standard_code_569[] = { 129, 141, 8, 187, 155, 176, 255 };
PROGMEM const char _dict_standard_word_570[] = "instead";
PROGMEM const uint8_t _dict_standard_code_570[] = { 129, 141, 187, 191, 8, 14, 131, 176, 255 };
PROGMEM const char _dict_standard_word_571[] = "instruct";
PROGMEM const uint8_t _dict_standard_code_571[] = { 129, 141, 187, 191, 7, 148, 7, 133, 197, 191, 255 };
PROGMEM const char _dict_standard_word_572[] = "interrupt";
PROGMEM const uint8_t _dict_standard_code_572[] = { 129, 141, 191, 133, 7, 148, 134, 198, 191, 255 };
PROGMEM const char _dict_standard_word_573[] = "into";
PROGMEM const uint8_t _dict_standard_code_573[] = { 129, 141, 191, 162, 255 };
PROGMEM const char _dict_standard_word_574[] = "intrigue";
PROGMEM const uint8_t _dict_standard_code_574[] = { 129, 141, 191, 7, 148, 128, 180, 255 };
PROGMEM const char _dict_standard_word_575[] = "intrigued";
PROGMEM const uint8_t _dict_standard_code_575[] = { 129, 141, 191, 7, 148, 128, 178, 176, 255 };
PROGMEM const char _dict_standard_word_576[] = "intrigues";
PROGMEM const uint8_t _dict_standard_code_576[] = { 129, 141, 191, 7, 148, 128, 178, 167, 255 };
PROGMEM const char _dict_standard_word_577[] = "intriguing";
PROGMEM const uint8_t _dict_standard_code_577[] = { 129, 141, 191, 7, 148, 128, 178, 129, 143, 255 };
PROGMEM const char _dict_standard_word_578[] = "intruder";
PROGMEM const uint8_t _dict_standard_code_578[] = { 129, 141, 191, 148, 139, 7, 174, 7, 133, 7, 151, 255 };
PROGMEM const char _dict_standard_word_579[] = "investigate";
PROGMEM const uint8_t _dict_standard_code_579[] = { 7, 129, 141, 166, 131, 187, 191, 129, 178, 7, 130, 7, 154, 191, 255 };
PROGMEM const char _dict_standard_word_580[] = "investigated";
PROGMEM const uint8_t _dict_standard_code_580[] = { 7, 129, 141, 166, 131, 187, 191, 129, 178, 7, 130, 7, 154, 191, 129, 176, 255 };
PROGMEM const char _dict_standard_word_581[] = "investigates";
PROGMEM const uint8_t _dict_standard_code_581[] = { 7, 129, 141, 166, 131, 187, 191, 129, 178, 7, 130, 7, 154, 191, 187, 255 };
PROGMEM const char _dict_standard_word_582[] = "investigating";
PROGMEM const uint8_t _dict_standard_code_582[] = { 7, 129, 141, 166, 131, 187, 191, 129, 178, 7, 130, 7, 154, 191, 129, 143, 255 };
PROGMEM const char _dict_standard_word_583[] = "investigator";
PROGMEM const uint8_t _dict_standard_code_583[] = { 7, 129, 141, 166, 131, 187, 191, 129, 178, 7, 130, 7, 154, 191, 7, 151, 255 };
PROGMEM const char _dict_standard_word_584[] = "investigators";
PROGMEM const uint8_t _dict_standard_code_584[] = { 7, 129, 141, 166, 131, 187, 191, 129, 178, 7, 130, 7, 154, 191, 7, 151, 7, 167, 255 };
PROGMEM const char _dict_standard_word_585[] = "invite";
PROGMEM const uint8_t _dict_standard_code_585[] = { 7, 129, 141, 166, 155, 191, 255 };
PROGMEM const char _dict_standard_word_586[] = "iota";
PROGMEM const uint8_t _dict_standard_code_586[] = { 155, 137, 191, 134, 255 };
PROGMEM const char _dict_standard_word_587[] = "iron";
PROGMEM const uint8_t _dict_standard_code_587[] = { 7, 135, 7, 157, 7, 133, 148, 142, 255 };
PROGMEM const char _dict_standard_word_588[] = "is";
PROGMEM const uint8_t _dict_standard_code_588[] = { 8, 129, 167, 255 };
PROGMEM const char _dict_standard_word_589[] = "island";
PROGMEM const uint8_t _dict_standard_code_589[] = { 7, 157, 7, 129, 145, 131, 141, 175, 255 };
PROGMEM const char _dict_standard_word_590[] = "it";
PROGMEM const uint8_t _dict_standard_code_590[] = { 8, 129, 8, 191, 255 };
PROGMEM const char _dict_standard_word_591[] = "j";
PROGMEM const uint8_t _dict_standard_code_591[] = { 165, 154, 255 };
PROGMEM const char _dict_standard_word_592[] = "jacket";
PROGMEM const uint8_t _dict_standard_code_592[] = { 165, 132, 194, 129, 191, 255 };
PROGMEM const char _dict_standard_word_593[] = "jam";
PROGMEM const uint8_t _dict_standard_code_593[] = { 165, 8, 132, 8, 140, 255 };
PROGMEM const char _dict_standard_word_594[] = "january";
PROGMEM const uint8_t _dict_standard_code_594[] = { 165, 132, 141, 7, 160, 7, 150, 128, 255 };
PROGMEM const char _dict_standard_word_595[] = "jar";
PROGMEM const uint8_t _dict_standard_code_595[] = { 165, 152, 255 };
PROGMEM const char _dict_standard_word_596[] = "jelly";
PROGMEM const uint8_t _dict_standard_code_596[] = { 165, 131, 145, 128, 255 };
PROGMEM const char _dict_standard_word_597[] = "jet";
PROGMEM const uint8_t _dict_standard_code_597[] = { 165, 131, 131, 191, 255 };
PROGMEM const char _dict_standard_word_598[] = "job";
PROGMEM const uint8_t _dict_standard_code_598[] = { 165, 136, 136, 4, 173, 255 };
PROGMEM const char _dict_standard_word_599[] = "joke";
PROGMEM const uint8_t _dict_standard_code_599[] = { 7, 165, 8, 137, 197, 255 };
PROGMEM const char _dict_standard_word_600[] = "joy";
PROGMEM const uint8_t _dict_standard_code_600[] = { 165, 156, 255 };
PROGMEM const char _dict_standard_word_601[] = "judge";
PROGMEM const uint8_t _dict_standard_code_601[] = { 165, 133, 133, 176, 165, 255 };
PROGMEM const char _dict_standard_word_602[] = "juice";
PROGMEM const uint8_t _dict_standard_code_602[] = { 165, 160, 187, 187, 255 };
PROGMEM const char _dict_standard_word_603[] = "july";
PROGMEM const uint8_t _dict_standard_code_603[] = { 165, 7, 162, 145, 157, 255 };
PROGMEM const char _dict_standard_word_604[] = "jump";
PROGMEM const uint8_t _dict_standard_code_604[] = { 165, 134, 140, 199, 255 };
PROGMEM const char _dict_standard_word_605[] = "jumped";
PROGMEM const uint8_t _dict_standard_code_605[] = { 165, 133, 140, 198, 191, 255 };
PROGMEM const char _dict_standard_word_606[] = "june";
PROGMEM const uint8_t _dict_standard_code_606[] = { 165, 160, 142, 255 };
PROGMEM const char _dict_standard_word_607[] = "just";
PROGMEM const uint8_t _dict_standard_code_607[] = { 165, 133, 187, 191, 255 };
PROGMEM const char _dict_standard_word_608[] = "k";
PROGMEM const uint8_t _dict_standard_code_608[] = { 194, 154, 255 };
PROGMEM const char _dict_standard_word_609[] = "kangaroo";
PROGMEM const uint8_t _dict_standard_code_609[] = { 194, 132, 7, 128, 143, 7, 133, 148, 138, 138, 255 };
PROGMEM const char _dict_standard_word_610[] = "kappa";
PROGMEM const uint8_t _dict_standard_code_610[] = { 194, 132, 199, 134, 255 };
PROGMEM const char _dict_standard_word_611[] = "keep";
PROGMEM const uint8_t _dict_standard_code_611[] = { 194, 8, 128, 198, 255 };
PROGMEM const char _dict_standard_word_612[] = "key";
PROGMEM const uint8_t _dict_standard_code_612[] = { 194, 128, 128, 255 };
PROGMEM const char _dict_standard_word_613[] = "kick";
PROGMEM const uint8_t _dict_standard_code_613[] = { 194, 129, 194, 255 };
PROGMEM const char _dict_standard_word_614[] = "kitchen";
PROGMEM const uint8_t _dict_standard_code_614[] = { 194, 129, 182, 131, 141, 255 };
PROGMEM const char _dict_standard_word_615[] = "kite";
PROGMEM const uint8_t _dict_standard_code_615[] = { 194, 157, 191, 255 };
PROGMEM const char _dict_standard_word_616[] = "knee";
PROGMEM const uint8_t _dict_standard_code_616[] = { 141, 128, 128, 255 };
PROGMEM const char _dict_standard_word_617[] = "knife";
PROGMEM const uint8_t _dict_standard_code_617[] = { 141, 155, 186, 255 };
PROGMEM const char _dict_standard_word_618[] = "knob";
PROGMEM const uint8_t _dict_standard_code_618[] = { 142, 135, 135, 173, 255 };
PROGMEM const char _dict_standard_word_619[] = "knock";
PROGMEM const uint8_t _dict_standard_code_619[] = { 141, 135, 195, 255 };
PROGMEM const char _dict_standard_word_620[] = "knot";
PROGMEM const uint8_t _dict_standard_code_620[] = { 141, 8, 135, 191, 255 };
PROGMEM const char _dict_standard_word_621[] = "know";
PROGMEM const uint8_t _dict_standard_code_621[] = { 142, 137, 164, 255 };
PROGMEM const char _dict_standard_word_622[] = "l";
PROGMEM const uint8_t _dict_standard_code_622[] = { 131, 159, 255 };
PROGMEM const char _dict_standard_word_623[] = "la";
PROGMEM const uint8_t _dict_standard_code_623[] = { 146, 135, 135, 255 };
PROGMEM const char _dict_standard_word_624[] = "ladder";
PROGMEM const uint8_t _dict_standard_code_624[] = { 145, 132, 174, 151, 255 };
PROGMEM const char _dict_standard_word_625[] = "lake";
PROGMEM const uint8_t _dict_standard_code_625[] = { 145, 154, 196, 255 };
PROGMEM const char _dict_standard_word_626[] = "lambda";
PROGMEM const uint8_t _dict_standard_code_626[] = { 145, 132, 140, 175, 134, 255 };
PROGMEM const char _dict_standard_word_627[] = "lamp";
PROGMEM const uint8_t _dict_standard_code_627[] = { 145, 132, 140, 199, 255 };
PROGMEM const char _dict_standard_word_628[] = "land";
PROGMEM const uint8_t _dict_standard_code_628[] = { 145, 132, 141, 175, 255 };
PROGMEM const char _dict_standard_word_629[] = "lapel";
PROGMEM const uint8_t _dict_standard_code_629[] = { 145, 134, 198, 131, 159, 255 };
PROGMEM const char _dict_standard_word_630[] = "large";
PROGMEM const uint8_t _dict_standard_code_630[] = { 145, 152, 165, 255 };
PROGMEM const char _dict_standard_word_631[] = "last";
PROGMEM const uint8_t _dict_standard_code_631[] = { 145, 8, 132, 187, 191, 255 };
PROGMEM const char _dict_standard_word_632[] = "late";
PROGMEM const uint8_t _dict_standard_code_632[] = { 145, 154, 191, 255 };
PROGMEM const char _dict_standard_word_633[] = "laugh";
PROGMEM const uint8_t _dict_standard_code_633[] = { 145, 132, 132, 186, 255 };
PROGMEM const char _dict_standard_word_634[] = "lay";
PROGMEM const uint8_t _dict_standard_code_634[] = { 145, 154, 7, 128, 255 };
PROGMEM const char _dict_standard_word_635[] = "lazy";
PROGMEM const uint8_t _dict_standard_code_635[] = { 145, 154, 7, 167, 128, 255 };
PROGMEM const char _dict_standard_word_636[] = "lead";
PROGMEM const uint8_t _dict_standard_code_636[] = { 145, 131, 131, 176, 255 };
PROGMEM const char _dict_standard_word_637[] = "leaf";
PROGMEM const uint8_t _dict_standard_code_637[] = { 145, 128, 186, 255 };
PROGMEM const char _dict_standard_word_638[] = "lean";
PROGMEM const uint8_t _dict_standard_code_638[] = { 145, 128, 141, 255 };
PROGMEM const char _dict_standard_word_639[] = "leap";
PROGMEM const uint8_t _dict_standard_code_639[] = { 145, 128, 198, 255 };
PROGMEM const char _dict_standard_word_640[] = "learn";
PROGMEM const uint8_t _dict_standard_code_640[] = { 145, 151, 141, 255 };
PROGMEM const char _dict_standard_word_641[] = "leash";
PROGMEM const uint8_t _dict_standard_code_641[] = { 145, 128, 128, 189, 189, 255 };
PROGMEM const char _dict_standard_word_642[] = "leave";
PROGMEM const uint8_t _dict_standard_code_642[] = { 145, 128, 166, 255 };
PROGMEM const char _dict_standard_word_643[] = "left";
PROGMEM const uint8_t _dict_standard_code_643[] = { 145, 131, 186, 191, 255 };
PROGMEM const char _dict_standard_word_644[] = "leg";
PROGMEM const uint8_t _dict_standard_code_644[] = { 145, 131, 180, 255 };
PROGMEM const char _dict_standard_word_645[] = "legislate";
PROGMEM const uint8_t _dict_standard_code_645[] = { 145, 131, 165, 131, 187, 145, 7, 154, 191, 255 };
PROGMEM const char _dict_standard_word_646[] = "legislated";
PROGMEM const uint8_t _dict_standard_code_646[] = { 145, 131, 165, 131, 187, 145, 7, 154, 191, 129, 176, 255 };
PROGMEM const char _dict_standard_word_647[] = "legislates";
PROGMEM const uint8_t _dict_standard_code_647[] = { 145, 131, 165, 131, 187, 145, 7, 154, 191, 187, 255 };
PROGMEM const char _dict_standard_word_648[] = "legislating";
PROGMEM const uint8_t _dict_standard_code_648[] = { 145, 131, 165, 131, 187, 145, 7, 154, 191, 129, 143, 255 };
PROGMEM const char _dict_standard_word_649[] = "legislature";
PROGMEM const uint8_t _dict_standard_code_649[] = { 145, 131, 165, 131, 187, 145, 7, 154, 182, 151, 255 };
PROGMEM const char _dict_standard_word_650[] = "lei";
PROGMEM const uint8_t _dict_standard_code_650[] = { 145, 154, 255 };
PROGMEM const char _dict_standard_word_651[] = "lemon";
PROGMEM const uint8_t _dict_standard_code_651[] = { 145, 131, 140, 133, 141, 255 };
PROGMEM const char _dict_standard_word_652[] = "length";
PROGMEM const uint8_t _dict_standard_code_652[] = { 145, 131, 143, 190, 255 };
PROGMEM const char _dict_standard_word_653[] = "less";
PROGMEM const uint8_t _dict_standard_code_653[] = { 145, 131, 187, 187, 255 };
PROGMEM const char _dict_standard_word_654[] = "let";
PROGMEM const uint8_t _dict_standard_code_654[] = { 145, 131, 191, 255 };
PROGMEM const char _dict_standard_word_655[] = "letter";
PROGMEM const uint8_t _dict_standard_code_655[] = { 145, 131, 191, 133, 148, 255 };
PROGMEM const char _dict_standard_word_656[] = "lettuce";
PROGMEM const uint8_t _dict_standard_code_656[] = { 145, 131, 191, 133, 187, 187, 255 };
PROGMEM const char _dict_standard_word_657[] = "library";
PROGMEM const uint8_t _dict_standard_code_657[] = { 145, 155, 172, 148, 7, 150, 128, 255 };
PROGMEM const char _dict_standard_word_658[] = "lid";
PROGMEM const uint8_t _dict_standard_code_658[] = { 145, 8, 129, 176, 255 };
PROGMEM const char _dict_standard_word_659[] = "lie";
PROGMEM const uint8_t _dict_standard_code_659[] = { 145, 155, 7, 128, 255 };
PROGMEM const char _dict_standard_word_660[] = "lift";
PROGMEM const uint8_t _dict_standard_code_660[] = { 145, 129, 186, 191, 255 };
PROGMEM const char _dict_standard_word_661[] = "light";
PROGMEM const uint8_t _dict_standard_code_661[] = { 145, 155, 191, 255 };
PROGMEM const char _dict_standard_word_662[] = "like";
PROGMEM const uint8_t _dict_standard_code_662[] = { 145, 7, 135, 7, 155, 196, 255 };
PROGMEM const char _dict_standard_word_663[] = "line";
PROGMEM const uint8_t _dict_standard_code_663[] = { 145, 155, 141, 255 };
PROGMEM const char _dict_standard_word_664[] = "linguist";
PROGMEM const uint8_t _dict_standard_code_664[] = { 145, 129, 143, 7, 147, 129, 187, 191, 255 };
PROGMEM const char _dict_standard_word_665[] = "lion";
PROGMEM const uint8_t _dict_standard_code_665[] = { 145, 155, 133, 141, 255 };
PROGMEM const char _dict_standard_word_666[] = "liquid";
PROGMEM const uint8_t _dict_standard_code_666[] = { 145, 129, 194, 7, 147, 129, 176, 255 };
PROGMEM const char _dict_standard_word_667[] = "listen";
PROGMEM const uint8_t _dict_standard_code_667[] = { 145, 129, 187, 131, 141, 255 };
PROGMEM const char _dict_standard_word_668[] = "lists";
PROGMEM const uint8_t _dict_standard_code_668[] = { 145, 129, 187, 193, 255 };
PROGMEM const char _dict_standard_word_669[] = "litter";
PROGMEM const uint8_t _dict_standard_code_669[] = { 145, 129, 191, 151, 255 };
PROGMEM const char _dict_standard_word_670[] = "little";
PROGMEM const uint8_t _dict_standard_code_670[] = { 145, 129, 191, 159, 255 };
PROGMEM const char _dict_standard_word_671[] = "lock";
PROGMEM const uint8_t _dict_standard_code_671[] = { 146, 135, 197, 255 };
PROGMEM const char _dict_standard_word_672[] = "long";
PROGMEM const uint8_t _dict_standard_code_672[] = { 146, 135, 8, 144, 255 };
PROGMEM const char _dict_standard_word_673[] = "look";
PROGMEM const uint8_t _dict_standard_code_673[] = { 146, 8, 14, 138, 197, 255 };
PROGMEM const char _dict_standard_word_674[] = "loose";
PROGMEM const uint8_t _dict_standard_code_674[] = { 145, 139, 139, 187, 255 };
PROGMEM const char _dict_standard_word_675[] = "lose";
PROGMEM const uint8_t _dict_standard_code_675[] = { 146, 8, 139, 7, 167, 255 };
PROGMEM const char _dict_standard_word_676[] = "loud";
PROGMEM const uint8_t _dict_standard_code_676[] = { 146, 163, 175, 255 };
PROGMEM const char _dict_standard_word_677[] = "love";
PROGMEM const uint8_t _dict_standard_code_677[] = { 146, 8, 134, 8, 166, 255 };
PROGMEM const char _dict_standard_word_678[] = "low";
PROGMEM const uint8_t _dict_standard_code_678[] = { 8, 146, 164, 255 };
PROGMEM const char _dict_standard_word_679[] = "luke";
PROGMEM const uint8_t _dict_standard_code_679[] = { 145, 162, 197, 255 };
PROGMEM const char _dict_standard_word_680[] = "lunch";
PROGMEM const uint8_t _dict_standard_code_680[] = { 146, 134, 8, 141, 182, 255 };
PROGMEM const char _dict_standard_word_681[] = "lynxmotion";
PROGMEM const uint8_t _dict_standard_code_681[] = { 145, 7, 129, 143, 195, 7, 188, 7, 140, 137, 189, 133, 141, 255 };
PROGMEM const char _dict_standard_word_682[] = "m";
PROGMEM const uint8_t _dict_standard_code_682[] = { 131, 131, 140, 255 };
PROGMEM const char _dict_standard_word_683[] = "machine";
PROGMEM const uint8_t _dict_standard_code_683[] = { 140, 7, 134, 8, 189, 128, 141, 255 };
PROGMEM const char _dict_standard_word_684[] = "magnevation";
PROGMEM const uint8_t _dict_standard_code_684[] = { 7, 140, 132, 178, 7, 141, 129, 166, 7, 154, 189, 133, 142, 255 };
PROGMEM const char _dict_standard_word_685[] = "mail";
PROGMEM const uint8_t _dict_standard_code_685[] = { 140, 154, 146, 255 };
PROGMEM const char _dict_standard_word_686[] = "make";
PROGMEM const uint8_t _dict_standard_code_686[] = { 140, 154, 196, 255 };
PROGMEM const char _dict_standard_word_687[] = "male";
PROGMEM const uint8_t _dict_standard_code_687[] = { 140, 154, 146, 255 };
PROGMEM const char _dict_standard_word_688[] = "mama";
PROGMEM const uint8_t _dict_standard_code_688[] = { 140, 135, 135, 140, 135, 255 };
PROGMEM const char _dict_standard_word_689[] = "man";
PROGMEM const uint8_t _dict_standard_code_689[] = { 140, 8, 132, 8, 141, 255 };
PROGMEM const char _dict_standard_word_690[] = "many";
PROGMEM const uint8_t _dict_standard_code_690[] = { 140, 131, 141, 128, 255 };
PROGMEM const char _dict_standard_word_691[] = "march";
PROGMEM const uint8_t _dict_standard_code_691[] = { 140, 152, 182, 255 };
PROGMEM const char _dict_standard_word_692[] = "marry";
PROGMEM const uint8_t _dict_standard_code_692[] = { 140, 150, 128, 255 };
PROGMEM const char _dict_standard_word_693[] = "match";
PROGMEM const uint8_t _dict_standard_code_693[] = { 140, 132, 8, 182, 255 };
PROGMEM const char _dict_standard_word_694[] = "may";
PROGMEM const uint8_t _dict_standard_code_694[] = { 140, 154, 255 };
PROGMEM const char _dict_standard_word_695[] = "maybe";
PROGMEM const uint8_t _dict_standard_code_695[] = { 140, 154, 172, 128, 255 };
PROGMEM const char _dict_standard_word_696[] = "me";
PROGMEM const uint8_t _dict_standard_code_696[] = { 140, 128, 128, 255 };
PROGMEM const char _dict_standard_word_697[] = "mean";
PROGMEM const uint8_t _dict_standard_code_697[] = { 140, 8, 128, 141, 255 };
PROGMEM const char _dict_standard_word_698[] = "measure";
PROGMEM const uint8_t _dict_standard_code_698[] = { 140, 131, 168, 7, 151, 255 };
PROGMEM const char _dict_standard_word_699[] = "measures";
PROGMEM const uint8_t _dict_standard_code_699[] = { 140, 131, 168, 7, 151, 7, 167, 255 };
PROGMEM const char _dict_standard_word_700[] = "melt";
PROGMEM const uint8_t _dict_standard_code_700[] = { 140, 131, 145, 191, 255 };
PROGMEM const char _dict_standard_word_701[] = "memories";
PROGMEM const uint8_t _dict_standard_code_701[] = { 140, 131, 140, 7, 151, 128, 7, 167, 255 };
PROGMEM const char _dict_standard_word_702[] = "memory";
PROGMEM const uint8_t _dict_standard_code_702[] = { 140, 131, 140, 7, 151, 128, 255 };
PROGMEM const char _dict_standard_word_703[] = "men";
PROGMEM const uint8_t _dict_standard_code_703[] = { 140, 131, 131, 141, 255 };
PROGMEM const char _dict_standard_word_704[] = "mend";
PROGMEM const uint8_t _dict_standard_code_704[] = { 140, 131, 141, 177, 255 };
PROGMEM const char _dict_standard_word_705[] = "merry";
PROGMEM const uint8_t _dict_standard_code_705[] = { 140, 131, 7, 150, 128, 255 };
PROGMEM const char _dict_standard_word_706[] = "metal";
PROGMEM const uint8_t _dict_standard_code_706[] = { 140, 131, 191, 159, 255 };
PROGMEM const char _dict_standard_word_707[] = "mice";
PROGMEM const uint8_t _dict_standard_code_707[] = { 140, 7, 135, 7, 155, 187, 187, 255 };
PROGMEM const char _dict_standard_word_708[] = "middle";
PROGMEM const uint8_t _dict_standard_code_708[] = { 140, 129, 175, 146, 255 };
PROGMEM const char _dict_standard_word_709[] = "might";
PROGMEM const uint8_t _dict_standard_code_709[] = { 140, 7, 135, 7, 155, 191, 255 };
PROGMEM const char _dict_standard_word_710[] = "milk";
PROGMEM const uint8_t _dict_standard_code_710[] = { 140, 129, 7, 145, 196, 255 };
PROGMEM const char _dict_standard_word_711[] = "million";
PROGMEM const uint8_t _dict_standard_code_711[] = { 140, 129, 7, 145, 7, 158, 8, 141, 255 };
PROGMEM const char _dict_standard_word_712[] = "mind";
PROGMEM const uint8_t _dict_standard_code_712[] = { 140, 7, 157, 7, 129, 141, 177, 255 };
PROGMEM const char _dict_standard_word_713[] = "mine";
PROGMEM const uint8_t _dict_standard_code_713[] = { 140, 155, 141, 255 };
PROGMEM const char _dict_standard_word_714[] = "minus";
PROGMEM const uint8_t _dict_standard_code_714[] = { 140, 7, 157, 7, 129, 7, 142, 8, 134, 187, 255 };
PROGMEM const char _dict_standard_word_715[] = "minute";
PROGMEM const uint8_t _dict_standard_code_715[] = { 140, 7, 129, 141, 129, 191, 255 };
PROGMEM const char _dict_standard_word_716[] = "mirror";
PROGMEM const uint8_t _dict_standard_code_716[] = { 140, 149, 153, 255 };
PROGMEM const char _dict_standard_word_717[] = "mistake";
PROGMEM const uint8_t _dict_standard_code_717[] = { 140, 7, 129, 187, 191, 154, 196, 255 };
PROGMEM const char _dict_standard_word_718[] = "mitten";
PROGMEM const uint8_t _dict_standard_code_718[] = { 140, 129, 8, 191, 7, 130, 141, 255 };
PROGMEM const char _dict_standard_word_719[] = "mix";
PROGMEM const uint8_t _dict_standard_code_719[] = { 140, 129, 194, 187, 255 };
PROGMEM const char _dict_standard_word_720[] = "monday";
PROGMEM const uint8_t _dict_standard_code_720[] = { 140, 134, 141, 174, 154, 255 };
PROGMEM const char _dict_standard_word_721[] = "money";
PROGMEM const uint8_t _dict_standard_code_721[] = { 140, 134, 141, 128, 255 };
PROGMEM const char _dict_standard_word_722[] = "monkey";
PROGMEM const uint8_t _dict_standard_code_722[] = { 140, 134, 141, 194, 128, 255 };
PROGMEM const char _dict_standard_word_723[] = "month";
PROGMEM const uint8_t _dict_standard_code_723[] = { 140, 134, 141, 190, 255 };
PROGMEM const char _dict_standard_word_724[] = "moon";
PROGMEM const uint8_t _dict_standard_code_724[] = { 140, 139, 141, 255 };
PROGMEM const char _dict_standard_word_725[] = "more";
PROGMEM const uint8_t _dict_standard_code_725[] = { 140, 7, 137, 153, 255 };
PROGMEM const char _dict_standard_word_726[] = "morning";
PROGMEM const uint8_t _dict_standard_code_726[] = { 140, 7, 137, 7, 153, 141, 129, 143, 255 };
PROGMEM const char _dict_standard_word_727[] = "most";
PROGMEM const uint8_t _dict_standard_code_727[] = { 140, 8, 137, 187, 191, 255 };
PROGMEM const char _dict_standard_word_728[] = "mother";
PROGMEM const uint8_t _dict_standard_code_728[] = { 140, 134, 190, 7, 151, 255 };
PROGMEM const char _dict_standard_word_729[] = "motor";
PROGMEM const uint8_t _dict_standard_code_729[] = { 140, 137, 191, 7, 151, 255 };
PROGMEM const char _dict_standard_word_730[] = "mountain";
PROGMEM const uint8_t _dict_standard_code_730[] = { 140, 7, 163, 141, 191, 130, 141, 255 };
PROGMEM const char _dict_standard_word_731[] = "mouse";
PROGMEM const uint8_t _dict_standard_code_731[] = { 140, 163, 187, 255 };
PROGMEM const char _dict_standard_word_732[] = "mouth";
PROGMEM const uint8_t _dict_standard_code_732[] = { 140, 163, 8, 190, 255 };
PROGMEM const char _dict_standard_word_733[] = "move";
PROGMEM const uint8_t _dict_standard_code_733[] = { 140, 8, 139, 166, 255 };
PROGMEM const char _dict_standard_word_734[] = "mu";
PROGMEM const uint8_t _dict_standard_code_734[] = { 140, 160, 255 };
PROGMEM const char _dict_standard_word_735[] = "much";
PROGMEM const uint8_t _dict_standard_code_735[] = { 140, 134, 182, 255 };
PROGMEM const char _dict_standard_word_736[] = "mud";
PROGMEM const uint8_t _dict_standard_code_736[] = { 140, 8, 134, 175, 255 };
PROGMEM const char _dict_standard_word_737[] = "museum";
PROGMEM const uint8_t _dict_standard_code_737[] = { 140, 160, 7, 167, 128, 7, 134, 140, 255 };
PROGMEM const char _dict_standard_word_738[] = "music";
PROGMEM const uint8_t _dict_standard_code_738[] = { 140, 160, 167, 129, 196, 255 };
PROGMEM const char _dict_standard_word_739[] = "must";
PROGMEM const uint8_t _dict_standard_code_739[] = { 140, 134, 187, 191, 255 };
PROGMEM const char _dict_standard_word_740[] = "my";
PROGMEM const uint8_t _dict_standard_code_740[] = { 140, 155, 255 };
PROGMEM const char _dict_standard_word_741[] = "myself";
PROGMEM const uint8_t _dict_standard_code_741[] = { 140, 155, 187, 131, 145, 186, 255 };
PROGMEM const char _dict_standard_word_742[] = "n";
PROGMEM const uint8_t _dict_standard_code_742[] = { 131, 131, 141, 255 };
PROGMEM const char _dict_standard_word_743[] = "nail";
PROGMEM const uint8_t _dict_standard_code_743[] = { 141, 154, 146, 255 };
PROGMEM const char _dict_standard_word_744[] = "name";
PROGMEM const uint8_t _dict_standard_code_744[] = { 141, 154, 140, 255 };
PROGMEM const char _dict_standard_word_745[] = "narrow";
PROGMEM const uint8_t _dict_standard_code_745[] = { 141, 150, 164, 255 };
PROGMEM const char _dict_standard_word_746[] = "nation";
PROGMEM const uint8_t _dict_standard_code_746[] = { 141, 154, 189, 133, 141, 255 };
PROGMEM const char _dict_standard_word_747[] = "near";
PROGMEM const uint8_t _dict_standard_code_747[] = { 141, 149, 255 };
PROGMEM const char _dict_standard_word_748[] = "nearly";
PROGMEM const uint8_t _dict_standard_code_748[] = { 141, 7, 149, 145, 128, 255 };
PROGMEM const char _dict_standard_word_749[] = "neck";
PROGMEM const uint8_t _dict_standard_code_749[] = { 141, 131, 196, 255 };
PROGMEM const char _dict_standard_word_750[] = "need";
PROGMEM const uint8_t _dict_standard_code_750[] = { 141, 8, 128, 176, 255 };
PROGMEM const char _dict_standard_word_751[] = "needle";
PROGMEM const uint8_t _dict_standard_code_751[] = { 141, 128, 175, 146, 255 };
PROGMEM const char _dict_standard_word_752[] = "neighbor";
PROGMEM const uint8_t _dict_standard_code_752[] = { 141, 154, 172, 151, 255 };
PROGMEM const char _dict_standard_word_753[] = "neither";
PROGMEM const uint8_t _dict_standard_code_753[] = { 141, 128, 190, 7, 151, 255 };
PROGMEM const char _dict_standard_word_754[] = "net";
PROGMEM const uint8_t _dict_standard_code_754[] = { 141, 131, 191, 255 };
PROGMEM const char _dict_standard_word_755[] = "network";
PROGMEM const uint8_t _dict_standard_code_755[] = { 141, 131, 191, 7, 147, 7, 151, 196, 255 };
PROGMEM const char _dict_standard_word_756[] = "never";
PROGMEM const uint8_t _dict_standard_code_756[] = { 141, 131, 7, 166, 151, 255 };
PROGMEM const char _dict_standard_word_757[] = "new";
PROGMEM const uint8_t _dict_standard_code_757[] = { 141, 160, 255 };
PROGMEM const char _dict_standard_word_758[] = "next";
PROGMEM const uint8_t _dict_standard_code_758[] = { 141, 131, 194, 187, 191, 255 };
PROGMEM const char _dict_standard_word_759[] = "nickel";
PROGMEM const uint8_t _dict_standard_code_759[] = { 141, 129, 194, 159, 255 };
PROGMEM const char _dict_standard_word_760[] = "night";
PROGMEM const uint8_t _dict_standard_code_760[] = { 141, 155, 191, 255 };
PROGMEM const char _dict_standard_word_761[] = "nine";
PROGMEM const uint8_t _dict_standard_code_761[] = { 141, 14, 157, 141, 255 };
PROGMEM const char _dict_standard_word_762[] = "nineteen";
PROGMEM const uint8_t _dict_standard_code_762[] = { 141, 7, 15, 155, 141, 191, 128, 8, 141, 255 };
PROGMEM const char _dict_standard_word_763[] = "ninety";
PROGMEM const uint8_t _dict_standard_code_763[] = { 141, 7, 15, 155, 141, 191, 128, 255 };
PROGMEM const char _dict_standard_word_764[] = "nip";
PROGMEM const uint8_t _dict_standard_code_764[] = { 141, 129, 198, 255 };
PROGMEM const char _dict_standard_word_765[] = "nipped";
PROGMEM const uint8_t _dict_standard_code_765[] = { 141, 129, 198, 4, 191, 255 };
PROGMEM const char _dict_standard_word_766[] = "nipping";
PROGMEM const uint8_t _dict_standard_code_766[] = { 141, 129, 198, 129, 143, 255 };
PROGMEM const char _dict_standard_word_767[] = "nips";
PROGMEM const uint8_t _dict_standard_code_767[] = { 141, 129, 198, 187, 255 };
PROGMEM const char _dict_standard_word_768[] = "no";
PROGMEM const uint8_t _dict_standard_code_768[] = { 142, 164, 255 };
PROGMEM const char _dict_standard_word_769[] = "nobody";
PROGMEM const uint8_t _dict_standard_code_769[] = { 142, 137, 7, 4, 18, 171, 135, 174, 128, 255 };
PROGMEM const char _dict_standard_word_770[] = "noise";
PROGMEM const uint8_t _dict_standard_code_770[] = { 142, 156, 7, 128, 187, 255 };
PROGMEM const char _dict_standard_word_771[] = "none";
PROGMEM const uint8_t _dict_standard_code_771[] = { 142, 8, 134, 141, 255 };
PROGMEM const char _dict_standard_word_772[] = "noon";
PROGMEM const uint8_t _dict_standard_code_772[] = { 142, 8, 139, 141, 255 };
PROGMEM const char _dict_standard_word_773[] = "nose";
PROGMEM const uint8_t _dict_standard_code_773[] = { 142, 164, 167, 255 };
PROGMEM const char _dict_standard_word_774[] = "not";
PROGMEM const uint8_t _dict_standard_code_774[] = { 141, 135, 191, 255 };
PROGMEM const char _dict_standard_word_775[] = "notice";
PROGMEM const uint8_t _dict_standard_code_775[] = { 142, 137, 191, 129, 187, 255 };
PROGMEM const char _dict_standard_word_776[] = "november";
PROGMEM const uint8_t _dict_standard_code_776[] = { 142, 137, 166, 7, 131, 140, 172, 7, 151, 255 };
PROGMEM const char _dict_standard_word_777[] = "now";
PROGMEM const uint8_t _dict_standard_code_777[] = { 142, 163, 255 };
PROGMEM const char _dict_standard_word_778[] = "nu";
PROGMEM const uint8_t _dict_standard_code_778[] = { 142, 162, 255 };
PROGMEM const char _dict_standard_word_779[] = "number";
PROGMEM const uint8_t _dict_standard_code_779[] = { 141, 134, 140, 18, 171, 148, 255 };
PROGMEM const char _dict_standard_word_780[] = "nurse";
PROGMEM const uint8_t _dict_standard_code_780[] = { 142, 151, 187, 255 };
PROGMEM const char _dict_standard_word_781[] = "nut";
PROGMEM const uint8_t _dict_standard_code_781[] = { 142, 134, 191, 255 };
PROGMEM const char _dict_standard_word_782[] = "o";
PROGMEM const uint8_t _dict_standard_code_782[] = { 137, 164, 255 };
PROGMEM const char _dict_standard_word_783[] = "oar";
PROGMEM const uint8_t _dict_standard_code_783[] = { 153, 7, 148, 255 };
PROGMEM const char _dict_standard_word_784[] = "obey";
PROGMEM const uint8_t _dict_standard_code_784[] = { 8, 137, 18, 171, 154, 255 };
PROGMEM const char _dict_standard_word_785[] = "object";
PROGMEM const uint8_t _dict_standard_code_785[] = { 135, 173, 165, 131, 196, 191, 255 };
PROGMEM const char _dict_standard_word_786[] = "ocean";
PROGMEM const uint8_t _dict_standard_code_786[] = { 137, 189, 133, 141, 255 };
PROGMEM const char _dict_standard_word_787[] = "october";
PROGMEM const uint8_t _dict_standard_code_787[] = { 135, 197, 191, 137, 18, 171, 7, 151, 255 };
PROGMEM const char _dict_standard_word_788[] = "octopus";
PROGMEM const uint8_t _dict_standard_code_788[] = { 7, 135, 195, 191, 7, 133, 199, 7, 138, 187, 255 };
PROGMEM const char _dict_standard_word_789[] = "of";
PROGMEM const uint8_t _dict_standard_code_789[] = { 8, 134, 166, 255 };
PROGMEM const char _dict_standard_word_790[] = "off";
PROGMEM const uint8_t _dict_standard_code_790[] = { 135, 135, 186, 186, 255 };
PROGMEM const char _dict_standard_word_791[] = "often";
PROGMEM const uint8_t _dict_standard_code_791[] = { 135, 186, 191, 131, 141, 255 };
PROGMEM const char _dict_standard_word_792[] = "old";
PROGMEM const uint8_t _dict_standard_code_792[] = { 137, 146, 175, 255 };
PROGMEM const char _dict_standard_word_793[] = "omega";
PROGMEM const uint8_t _dict_standard_code_793[] = { 137, 140, 154, 178, 134, 255 };
PROGMEM const char _dict_standard_word_794[] = "omicron";
PROGMEM const uint8_t _dict_standard_code_794[] = { 137, 140, 129, 195, 148, 135, 142, 255 };
PROGMEM const char _dict_standard_word_795[] = "on";
PROGMEM const uint8_t _dict_standard_code_795[] = { 135, 135, 142, 255 };
PROGMEM const char _dict_standard_word_796[] = "once";
PROGMEM const uint8_t _dict_standard_code_796[] = { 147, 134, 141, 187, 255 };
PROGMEM const char _dict_standard_word_797[] = "one";
PROGMEM const uint8_t _dict_standard_code_797[] = { 147, 14, 135, 8, 141, 255 };
PROGMEM const char _dict_standard_word_798[] = "only";
PROGMEM const uint8_t _dict_standard_code_798[] = { 137, 142, 145, 128, 255 };
PROGMEM const char _dict_standard_word_799[] = "oopic";
PROGMEM const uint8_t _dict_standard_code_799[] = { 8, 139, 199, 8, 129, 196, 255 };
PROGMEM const char _dict_standard_word_800[] = "open";
PROGMEM const uint8_t _dict_standard_code_800[] = { 137, 199, 131, 142, 255 };
PROGMEM const char _dict_standard_word_801[] = "or";
PROGMEM const uint8_t _dict_standard_code_801[] = { 153, 255 };
PROGMEM const char _dict_standard_word_802[] = "orange";
PROGMEM const uint8_t _dict_standard_code_802[] = { 153, 141, 165, 255 };
PROGMEM const char _dict_standard_word_803[] = "other";
PROGMEM const uint8_t _dict_standard_code_803[] = { 134, 190, 151, 255 };
PROGMEM const char _dict_standard_word_804[] = "ouch";
PROGMEM const uint8_t _dict_standard_code_804[] = { 163, 182, 255 };
PROGMEM const char _dict_standard_word_805[] = "ought";
PROGMEM const uint8_t _dict_standard_code_805[] = { 136, 136, 191, 255 };
PROGMEM const char _dict_standard_word_806[] = "our";
PROGMEM const uint8_t _dict_standard_code_806[] = { 163, 148, 255 };
PROGMEM const char _dict_standard_word_807[] = "out";
PROGMEM const uint8_t _dict_standard_code_807[] = { 163, 191, 255 };
PROGMEM const char _dict_standard_word_808[] = "outdoors";
PROGMEM const uint8_t _dict_standard_code_808[] = { 163, 191, 8, 175, 153, 187, 255 };
PROGMEM const char _dict_standard_word_809[] = "over";
PROGMEM const uint8_t _dict_standard_code_809[] = { 8, 137, 7, 166, 151, 255 };
PROGMEM const char _dict_standard_word_810[] = "owl";
PROGMEM const uint8_t _dict_standard_code_810[] = { 163, 146, 255 };
PROGMEM const char _dict_standard_word_811[] = "own";
PROGMEM const uint8_t _dict_standard_code_811[] = { 137, 8, 141, 255 };
PROGMEM const char _dict_standard_word_812[] = "oz";
PROGMEM const uint8_t _dict_standard_code_812[] = { 135, 135, 167, 255 };
PROGMEM const char _dict_standard_word_813[] = "p";
PROGMEM const uint8_t _dict_standard_code_813[] = { 198, 128, 128, 255 };
PROGMEM const char _dict_standard_word_814[] = "package";
PROGMEM const uint8_t _dict_standard_code_814[] = { 198, 8, 132, 194, 131, 165, 255 };
PROGMEM const char _dict_standard_word_815[] = "paint";
PROGMEM const uint8_t _dict_standard_code_815[] = { 198, 7, 130, 7, 154, 141, 191, 255 };
PROGMEM const char _dict_standard_word_816[] = "paintbrush";
PROGMEM const uint8_t _dict_standard_code_816[] = { 198, 7, 154, 141, 191, 18, 171, 7, 148, 134, 189, 255 };
PROGMEM const char _dict_standard_word_817[] = "pan";
PROGMEM const uint8_t _dict_standard_code_817[] = { 199, 8, 132, 142, 255 };
PROGMEM const char _dict_standard_word_818[] = "pants";
PROGMEM const uint8_t _dict_standard_code_818[] = { 199, 132, 142, 191, 187, 255 };
PROGMEM const char _dict_standard_word_819[] = "paper";
PROGMEM const uint8_t _dict_standard_code_819[] = { 198, 7, 154, 198, 151, 255 };
PROGMEM const char _dict_standard_word_820[] = "parakeet";
PROGMEM const uint8_t _dict_standard_code_820[] = { 198, 7, 150, 134, 194, 128, 191, 255 };
PROGMEM const char _dict_standard_word_821[] = "parent";
PROGMEM const uint8_t _dict_standard_code_821[] = { 199, 132, 7, 148, 7, 131, 141, 191, 255 };
PROGMEM const char _dict_standard_word_822[] = "park";
PROGMEM const uint8_t _dict_standard_code_822[] = { 199, 7, 152, 7, 148, 196, 255 };
PROGMEM const char _dict_standard_word_823[] = "parrot";
PROGMEM const uint8_t _dict_standard_code_823[] = { 198, 150, 134, 191, 255 };
PROGMEM const char _dict_standard_word_824[] = "part";
PROGMEM const uint8_t _dict_standard_code_824[] = { 199, 152, 191, 255 };
PROGMEM const char _dict_standard_word_825[] = "parts";
PROGMEM const uint8_t _dict_standard_code_825[] = { 199, 152, 193, 255 };
PROGMEM const char _dict_standard_word_826[] = "pass";
PROGMEM const uint8_t _dict_standard_code_826[] = { 199, 132, 187, 255 };
PROGMEM const char _dict_standard_word_827[] = "past";
PROGMEM const uint8_t _dict_standard_code_827[] = { 199, 132, 8, 187, 191, 255 };
PROGMEM const char _dict_standard_word_828[] = "paste";
PROGMEM const uint8_t _dict_standard_code_828[] = { 198, 154, 187, 191, 255 };
PROGMEM const char _dict_standard_word_829[] = "path";
PROGMEM const uint8_t _dict_standard_code_829[] = { 199, 132, 8, 190, 255 };
PROGMEM const char _dict_standard_word_830[] = "paw";
PROGMEM const uint8_t _dict_standard_code_830[] = { 199, 8, 135, 135, 255 };
PROGMEM const char _dict_standard_word_831[] = "pea";
PROGMEM const uint8_t _dict_standard_code_831[] = { 198, 128, 128, 255 };
PROGMEM const char _dict_standard_word_832[] = "peace";
PROGMEM const uint8_t _dict_standard_code_832[] = { 198, 8, 128, 187, 255 };
PROGMEM const char _dict_standard_word_833[] = "peach";
PROGMEM const uint8_t _dict_standard_code_833[] = { 198, 8, 128, 182, 255 };
PROGMEM const char _dict_standard_word_834[] = "peanut";
PROGMEM const uint8_t _dict_standard_code_834[] = { 198, 7, 128, 142, 134, 191, 255 };
PROGMEM const char _dict_standard_word_835[] = "pear";
PROGMEM const uint8_t _dict_standard_code_835[] = { 199, 150, 255 };
PROGMEM const char _dict_standard_word_836[] = "peck";
PROGMEM const uint8_t _dict_standard_code_836[] = { 198, 131, 131, 196, 255 };
PROGMEM const char _dict_standard_word_837[] = "peg";
PROGMEM const uint8_t _dict_standard_code_837[] = { 198, 131, 131, 8, 180, 255 };
PROGMEM const char _dict_standard_word_838[] = "pen";
PROGMEM const uint8_t _dict_standard_code_838[] = { 198, 131, 141, 255 };
PROGMEM const char _dict_standard_word_839[] = "pencil";
PROGMEM const uint8_t _dict_standard_code_839[] = { 198, 7, 131, 141, 187, 133, 146, 255 };
PROGMEM const char _dict_standard_word_840[] = "penguin";
PROGMEM const uint8_t _dict_standard_code_840[] = { 198, 130, 7, 143, 7, 147, 129, 141, 255 };
PROGMEM const char _dict_standard_word_841[] = "penny";
PROGMEM const uint8_t _dict_standard_code_841[] = { 198, 131, 141, 128, 255 };
PROGMEM const char _dict_standard_word_842[] = "people";
PROGMEM const uint8_t _dict_standard_code_842[] = { 198, 7, 128, 198, 8, 145, 255 };
PROGMEM const char _dict_standard_word_843[] = "peppers";
PROGMEM const uint8_t _dict_standard_code_843[] = { 198, 131, 199, 7, 151, 7, 167, 255 };
PROGMEM const char _dict_standard_word_844[] = "perhaps";
PROGMEM const uint8_t _dict_standard_code_844[] = { 199, 7, 151, 184, 132, 198, 187, 255 };
PROGMEM const char _dict_standard_word_845[] = "pet";
PROGMEM const uint8_t _dict_standard_code_845[] = { 199, 131, 191, 255 };
PROGMEM const char _dict_standard_word_846[] = "peter";
PROGMEM const uint8_t _dict_standard_code_846[] = { 198, 7, 128, 191, 133, 148, 255 };
PROGMEM const char _dict_standard_word_847[] = "phase";
PROGMEM const uint8_t _dict_standard_code_847[] = { 186, 154, 167, 255 };
PROGMEM const char _dict_standard_word_848[] = "phi";
PROGMEM const uint8_t _dict_standard_code_848[] = { 186, 155, 255 };
PROGMEM const char _dict_standard_word_849[] = "physical";
PROGMEM const uint8_t _dict_standard_code_849[] = { 186, 129, 167, 129, 194, 159, 255 };
PROGMEM const char _dict_standard_word_850[] = "pi";
PROGMEM const uint8_t _dict_standard_code_850[] = { 199, 155, 255 };
PROGMEM const char _dict_standard_word_851[] = "piano";
PROGMEM const uint8_t _dict_standard_code_851[] = { 198, 128, 132, 142, 137, 255 };
PROGMEM const char _dict_standard_word_852[] = "pick";
PROGMEM const uint8_t _dict_standard_code_852[] = { 198, 129, 195, 255 };
PROGMEM const char _dict_standard_word_853[] = "picked";
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
